udaravima/Lab_Bench/hardware/phase2-module/drc-report.txt

** Drc report for ../phase2-module.kicad_pcb **
** Created on 2026-09-27 23:24:25 **

** Found 19 DRC violations **
[silk_overlap]: Silkscreen overlap
    Rule: board setup constraints silk; Severity: warning
    @(110.5800 mm, 50.9700 mm): Reference 'R8'
    @(110.5800 mm, 50.5200 mm): Reference 'C24'
[silk_overlap]: Silkscreen overlap
    Rule: board setup constraints silk; Severity: warning
    @(92.5300 mm, 92.0300 mm): Reference 'C64'
    @(94.0000 mm, 92.1500 mm): Reference 'U10'
[silk_overlap]: Silkscreen overlap
    Rule: board setup constraints silk; Severity: warning
    @(95.1300 mm, 105.0700 mm): Reference 'R67'
    @(97.0000 mm, 105.0700 mm): Reference 'R68'
[silk_overlap]: Silkscreen overlap
    Rule: board setup constraints silk; Severity: warning
    @(102.3200 mm, 94.8200 mm): Reference 'R52'
    @(102.0700 mm, 95.3000 mm): Reference 'R16'
[silk_overlap]: Silkscreen overlap
    Rule: board setup constraints silk; Severity: warning
    @(113.0750 mm, 105.1000 mm): Reference 'J2'
    @(113.0000 mm, 105.0300 mm): Reference 'R35'
[silk_overlap]: Silkscreen overlap
    Rule: board setup constraints silk; Severity: warning
    @(103.9700 mm, 100.9000 mm): Reference 'C43'
    @(103.3700 mm, 100.7300 mm): Reference 'R64'
[silk_overlap]: Silkscreen overlap
    Rule: board setup constraints silk; Severity: warning
    @(131.1500 mm, 83.5400 mm): Line on F.Silkscreen
    @(131.0600 mm, 74.6044 mm): Line on F.Silkscreen
[silk_overlap]: Silkscreen overlap
    Rule: board setup constraints silk; Severity: warning
    @(60.2200 mm, 46.4000 mm): Reference 'R73'
    @(60.5000 mm, 47.2700 mm): Reference 'R75'
[silk_over_copper]: Silkscreen clipped by solder mask
    Local override; Severity: warning
    @(114.0200 mm, 93.3000 mm): Reference 'Q5'
[silk_over_copper]: Silkscreen clipped by solder mask
    Local override; Severity: warning
    @(110.0000 mm, 102.9500 mm): Reference 'U7'
[silk_over_copper]: Silkscreen clipped by solder mask
    Local override; Severity: warning
    @(107.8500 mm, 92.8500 mm): Reference 'D4'
[silk_over_copper]: Silkscreen clipped by solder mask
    Local override; Severity: warning
    @(105.9300 mm, 53.1200 mm): Reference 'R5'
[silk_over_copper]: Silkscreen clipped by solder mask
    Local override; Severity: warning
    @(109.9300 mm, 93.3000 mm): Reference 'Q6'
[silk_edge_clearance]: Silkscreen clipped by board edge
    Rule: board setup constraints silk; Severity: warning
    @(150.0000 mm, 110.0000 mm): Line on Edge.Cuts
    @(93.7800 mm, 110.0800 mm): Reference 'R65'
[via_dangling]: Via is not connected or connected on only one layer
    Local override; Severity: warning
    @(98.9500 mm, 108.7500 mm): Via [5V0] on F.Cu - B.Cu
[track_dangling]: Track has unconnected end
    Local override; Severity: warning
    @(106.1750 mm, 55.3500 mm): Track [PS_DITH] on In2.Cu, length 8.9095 mm
[via_dangling]: Via is not connected or connected on only one layer
    Local override; Severity: warning
    @(97.2500 mm, 49.3000 mm): Via [PS_FPWM] on F.Cu - B.Cu
[via_dangling]: Via is not connected or connected on only one layer
    Local override; Severity: warning
    @(97.9000 mm, 50.6000 mm): Via [PS_RES] on F.Cu - B.Cu
[via_dangling]: Via is not connected or connected on only one layer
    Local override; Severity: warning
    @(95.2500 mm, 50.1000 mm): Via [PS_RT] on F.Cu - B.Cu

** Found 0 unconnected pads **

** Found 0 Footprint errors **

** End of Report **
