udaravima/Lab_Bench/hardware/phase3-backplane/drc-report.txt

** Drc report for /home/fire310w/Documents/Hobbies/Lab_Bench/hardware/phase3-backplane/tools/../phase3-backplane.kicad_pcb **
** Created on 2026-07-26 07:59:22 **

** Found 0 DRC violations **

** Found 0 unconnected pads **

** Found 0 Footprint errors **

** End of Report **
