udaravima/Lab_Bench/docs/10-manager-firmware.md

# 10 — Manager Firmware (ESP32-S3, Phase 3)

Firmware in `firmware/manager/` for the rack controller. Same split as the
module firmware (docs/07): a **hardware-independent core**
(`firmware/manager/core/manager_core.{h,c}`, host-tested in
`firmware/tests`) implements every protocol/policy decision; a thin
ESP-IDF shell binds it to TWAI, I²C, USB and the UI. The core reuses
`firmware/common/labbench_can.h` verbatim.

## Design rule

**The manager is never safety-critical.** Modules self-regulate and
self-protect (docs/01); a manager crash mid-charge leaves the module's
analog CV/CC + local watchdogs in charge (comms-loss policy, docs/03 §6).
The manager's own hard action — E-stop — is a GPIO pulling the hardware
/HW_ENABLE line that works with the core hung.

## Core responsibilities (all in manager_core, host-tested)

| Function | Spec | Mechanism |
|---|---|---|
| Discovery | docs/03 §6 | HELLO ⇒ channel known; PRESENT mask (TCA9535) shows seated-but-silent slots |
| Supervision | matrix #15 | STATUS is the module heartbeat: >1 s silent ⇒ lost, alarmed, dropped from the budget |
| Heartbeat | docs/03 §6 | GLOBAL_STATE at 1 Hz (budget, flags, rolling seq) |
| Setpoint ack/retry | docs/03 §3 | SET_VI pending until a STATUS echoes the new setpoints; retry at 50 ms, 3 attempts, then `unresponsive` |
| Budget arbiter | docs/01 §2, matrix #17 | committed = Σ active channels max(measured, vset×iset) + request; refuse enables/raises that exceed it |
| Charge sequencer | docs/03 §7 | per-channel CC→CV→cutoff profile; only *schedules setpoints* — module analog loops regulate |
| Global off / E-stop | matrix #16 | GLOBAL_OFF broadcast (core) + /HW_ENABLE GPIO (shell, works even if core wedges) |

Charge sequencer states:
`IDLE → RAMP (LIMITS hold + SET_VI + OUTPUT on+DEM) → CC (STATUS.CC-active)
→ CV (CC-active clears near V_float) → TERM_WAIT (I < I_cutoff, hold
timer) → DONE (OUTPUT off)`; any module fault, channel loss, or the t_max
guard ⇒ `ABORT` (OUTPUT off, latched reason). Termination uses TELEM_VI
current, cutoff hold defaults 30 s.

Core I/O contract (no HAL, no floats, no allocation): frames in via
`lb_mgr_rx()`, time via `lb_mgr_tick(dt_ms)`, requests via `lb_mgr_*()`
calls; outgoing frames accumulate in a fixed ring drained by
`lb_mgr_tx_pop()`. Same host-test harness as module_core
(`cd firmware/tests && make test`).

## UI and SCPI cores (v0.2 — host-tested like manager_core)

Two more hardware-independent cores sit beside manager_core, same rules
(C99, no floats, no allocation), so **every** UI/SCPI decision is
host-verified before silicon:

- **`ui_core.{h,c}`** (tests/test_ui.c): front-panel state machine +
  renderer. Consumes encoder/key events, renders a 40×15 **text model**
  (`text[][]` + per-row attribute NORM/SEL/ALERT/EDIT + `beep` flag);
  the shell only paints glyphs. Screens: channel LIST (8 rows + budget
  header), channel DETAIL (setpoints/telemetry/output/fault-clear/charge
  abort), digit-wise EDIT (rotate = ±digit, push = next digit, hold =
  commit through the budget arbiter), SYSTEM (budget edit, global
  off/resume, all-off, backplane INA228 bus meter). Front-panel keys
  toggle their channel's output from any screen; refusals and new fault
  bits raise a message line + beep (edge-triggered, once per fault bit).
- **`scpi_core.{h,c}`** (tests/test_scpi.c): line-in/reply-out SCPI
  (docs/01 §6): `*IDN?`, `*RST`, `SOURn:VOLT|CURR` (set/query, decimal
  parsed to µV/µA integer), `MEASn:VOLT?|CURR?|POW?`, `OUTPn
  ON|OFF|DEM|DROOP|DEMDROOP` + live `OUTPn?`, `SYST:BUDG`,
  `SYST:SLOTn?` status CSV, `SYST:ERR?` FIFO (depth 4 + overflow mark).
  Set commands the core refuses (budget #17, lost channel) queue
  `-221,"Settings conflict"` — remote scripts see exactly the arbiter
  the UI sees.

## ESP-IDF shell (firmware/manager/idf/ — requires ESP-IDF ≥5.1 to build)

Managed components (main/idf_component.yml, fetched on first `idf.py
build`): `espressif/esp_lcd_ili9341`, `espressif/esp_tinyusb`.

**First compile (2026-09-27): builds clean, zero warnings in `main`,**
IDF v5.3.2, 355 KB app image (IRAM full at 16383/16384 B, from IDF +
TinyUSB, not our code). Built with esp_lcd_ili9341 1.2.0, esp_tinyusb
1.7.6~1, tinyusb 0.18.0~6. Two fixes were needed: `CONFIG_TINYUSB_CDC_ENABLED=y`
in sdkconfig.defaults (esp_tinyusb ships CDC off, so `tusb_cdc_acm.h`
hard-errors), and `esp_lcd_ili9341`/`esp_tinyusb` named in main's
`REQUIRES` so the includes resolve whether components come from the
registry or from local copies (`IDF_COMPONENT_MANAGER=0` +
`EXTRA_COMPONENT_DIRS`). Still untested on silicon.

| Piece | Binding |
|---|---|
| TWAI @ 500 k | IO4 TX / IO5 RX (docs/09 §3), rx task → `lb_mgr_rx`, 10 ms tick drains the ring |
| Tick | 10 ms esp_timer → `lb_mgr_tick` |
| I²C | IO8/IO9: TCA9535 (0x20, PRESENT+keys polled at 60 ms; INT on IO7 is a bring-up TODO) + backplane INA228 (0x40: 250 µΩ, ADCRANGE=0, CURRENT_LSB 400 µA, SHUNT_CAL 1311, 1 Hz poll → bus meter row) |
| E-stop | IO21 kill FET (assert), IO38 line sense (UI alert = bring-up TODO) |
| Display | `display.c`: esp_lcd + ILI9341 @20 MHz SPI2, paints the ui_core text model with the 8×16 VGA font (`font8x16.h`, machine-extracted from the system PSF font by `tools/gen_font.py` — never hand-typed). Rotation + RGB565 byte order are THE two bring-up knobs. Backlight = LEDC on IO16. Touch parked (T_CS held high) |
| Encoder | `encoder.c`: PCNT ×4 quadrature + glitch filter, 4 counts/detent; SW: <700 ms = push, 700 ms = hold |
| SCPI | `scpi_usb.c`: TinyUSB CDC-ACM on the native USB PHY, line buffer → `lb_scpi_line` under the manager mutex |
| Buzzer | IO41, 60 ms one-shot pulse on ui_core's `beep` |
| Wi-Fi | later phase; nothing in the cores depends on it |

Locking: one mutex guards the three cores; takers are the CAN rx task,
the 10 ms tick, the 20 ms UI task and the TinyUSB rx callback. The shell
compiles-by-inspection only — it is **not** built in CI here (no ESP-IDF
on this machine) — the core logic is what's verified, by the host suite,
exactly like the module firmware before its silicon.

## Bring-up checklist

1. Host: `cd firmware/tests && make test` — manager suite green.
2. Bench: manager + USB-CAN dongle sniffing: GLOBAL_STATE at 1 Hz, seq
   increments; E-stop key drops /HW_ENABLE (scope, <1 ms — exit criterion).
3. With one module on the bench harness: HELLO seen, channel appears,
   SET_VI/OUTPUT round-trip, STATUS ack clears the retry state.
4. Pull the module's CAN mid-run: lost alarm at 1 s, budget shrinks,
   module's own comms-loss policy fires at 3 s (its exit criterion).
5. Charge-sequence a bench battery through CC→CV→cutoff; reboot the
   manager mid-charge: module holds (policy=hold), sequencer resumes
   supervision from telemetry (docs/05 Phase-3 exit criterion).
6. Display: expect rotation/byte-order wrong on first light-up — flip
   `swap_xy`/`mirror` and the palette byteswap in display.c, nothing
   else. Then encoder direction (swap the two PCNT channels if CW/CCW
   are reversed).
7. SCPI: `*IDN?` over /dev/ttyACM*, then script a SOUR/OUTP/MEAS
   round-trip against a live module; verify a budget-refused `SOURn`
   answers `SYST:ERR?` with -221.
