udaravima/Lab_Bench/hardware/phase1-module/bom/phase1-module-bom.csv

Item | Qty | References | Value | Footprint | LCSC | MPN | Manufacturer | Unit USD | Ext USD | Note
1 | 1 | C1 | 10n | Capacitor_SMD:C_0603_1608Metric | C57112 | 0603B103K500NT | FH | 0.0108 | 0.011
2 | 1 | C2 | 22n | Capacitor_SMD:C_0603_1608Metric | C21122 | CL10B223KB8NNNC | Samsung Electro-Mechanics | 0.0083 | 0.008
3 | 17 | C3 C5 C27 C28 C33 C34 C41 C43 C52 C62 C68 C69 C70 C71 C72 C73 C74 | 100n | Capacitor_SMD:C_0603_1608Metric | C14663 | CC0603KRX7R9BB104 | YAGEO | 0.0122 | 0.207
4 | 1 | C4 | 150n | Capacitor_SMD:C_0603_1608Metric | C513735 | CC0603KRX7R9BB154 | YAGEO | 0.013 | 0.013 | 50 V part (no Basic 150 nF)
5 | 1 | C17 | DNP | Capacitor_SMD:C_0603_1608Metric |  |  |  |  |  | do not populate (value says DNP)
6 | 1 | C18 | 47n | Capacitor_SMD:C_0603_1608Metric | C1622 | CL10B473KB8NNNC | Samsung Electro-Mechanics | 0.0073 | 0.007
7 | 1 | C19 | 15p | Capacitor_SMD:C_0603_1608Metric | C1644 | CL10C150JB8NNNC | Samsung Electro-Mechanics | 0.0113 | 0.011 | C0G
8 | 4 | C20 C75 C76 C77 | 10u/50V X7R | Capacitor_SMD:C_1210_3225Metric | C77102 | GRM32ER71H106KA12L | Murata Electronics | 0.3274 | 1.31 | 10 uF 50 V X7R: no 22 uF 50 V 1210 is stocked, so the design value is now 10u (phase-2 uses 10 uF too). 4 x ~4.5 uF at 30 V bias gives about 0.3 Vpp input ripple at 8 A, D = 0.5, 350 kHz; ~1 A RMS each; C21 is the bulk
9 | 1 | C21 | 220u/50V | Capacitor_SMD:CP_Elec_10x10.5 | C2887271 | RVT220UF50V67RV0021 | KNSCHA | 0.1412 | 0.141 | SMD D10x10.2 aluminium, fits CP_Elec_10x10.5
10 | 2 | C22 C78 | 220u/25V poly | Capacitor_SMD:CP_Elec_8x11.9 | C46550471 | MA35V220M8X12 | jieerrui | 0.2872 | 0.574 | 35 V polymer SMD D8x11.5, 16 mOhm; fits CP_Elec_8x11.9
11 | 4 | C23 C79 C80 C81 | 22u/25V X7R | Capacitor_SMD:C_1210_3225Metric | C5341638 | CC1210KKX7R8BB226 | YAGEO | 0.596 | 2.384 | 22 uF 25 V X7R 1210; the 5V0/3V3 positions (16 V/10 V in the value) get the same part
12 | 1 | C24 | 8.2n | Capacitor_SMD:C_0603_1608Metric | C1322360 | 0603B822K500NT | FH | 0.0053 | 0.005
13 | 1 | C25 | 120p | Capacitor_SMD:C_0603_1608Metric | C1643 | 0603CG121J500NT | FH | 0.0132 | 0.013 | C0G
14 | 1 | C26 | 3.3n | Capacitor_SMD:C_0603_1608Metric | C1613 | CL10B332KB8NNNC | Samsung Electro-Mechanics | 0.0083 | 0.008
15 | 1 | C29 | 2.2u | Capacitor_SMD:C_0603_1608Metric | C23630 | CL10A225KO8NNNC | Samsung Electro-Mechanics | 0.0181 | 0.018 | 16 V X5R on the 7.5 V VCC rail
16 | 3 | C31 C32 C44 | 1n | Capacitor_SMD:C_0603_1608Metric | C1588 | CL10B102KB8NNNC | Samsung Electro-Mechanics | 0.0089 | 0.027
17 | 2 | C42 C53 | 1u | Capacitor_SMD:C_0603_1608Metric | C15849 | CL10A105KB8NNNC | Samsung Electro-Mechanics | 0.0752 | 0.15
18 | 2 | C50 C51 | 4.7u/50V | Capacitor_SMD:C_1210_3225Metric | C596318 | CC1210KKX7R9BB475 | YAGEO | 0.3807 | 0.761
19 | 2 | C54 C55 | 22u/16V | Capacitor_SMD:C_1210_3225Metric | C5341638 | CC1210KKX7R8BB226 | YAGEO | 0.596 | 1.192 | 22 uF 25 V X7R 1210; the 5V0/3V3 positions (16 V/10 V in the value) get the same part
20 | 1 | C56 | 10u/16V | Capacitor_SMD:C_1210_3225Metric | C77102 | GRM32ER71H106KA12L | Murata Electronics | 0.3274 | 0.327 | 10 uF 50 V X7R, same part as C20 (value says 16 V)
21 | 1 | C57 | 22u/10V | Capacitor_SMD:C_1210_3225Metric | C5341638 | CC1210KKX7R8BB226 | YAGEO | 0.596 | 0.596 | 22 uF 25 V X7R 1210; the 5V0/3V3 positions (16 V/10 V in the value) get the same part
22 | 1 | C64 | 4.7u | Capacitor_SMD:C_0603_1608Metric | C19666 | CL10A475KO8NNNC | Samsung Electro-Mechanics | 0.0294 | 0.029
23 | 1 | C65 | 1u VDDA | Capacitor_SMD:C_0603_1608Metric | C15849 | CL10A105KB8NNNC | Samsung Electro-Mechanics | 0.0752 | 0.075
24 | 2 | C66 C67 | 18p | Capacitor_SMD:C_0603_1608Metric | C1647 | CL10C180JB8NNNC | Samsung Electro-Mechanics | 0.0157 | 0.031 | C0G
25 | 4 | D1 D2 D3 D4 | BAT54W | Package_TO_SOT_SMD:SOT-323_SC-70 | C77328 | BAT54W | Jiangsu Changjing Electronics Technology Co., Ltd. | 0.0238 | 0.095 | SOT-323 single, pin 1 A / pin 3 K / pin 2 NC - check the rotation in the JLCPCB preview
26 | 1 | D5 | SMBJ33A | Diode_SMD:D_SMB | C224019 | SMBJ33A | Littelfuse | 0.122 | 0.122
27 | 1 | D6 | 1N4148W | Diode_SMD:D_SOD-323 | C2128 | 1N4148WS | Jiangsu Changjing Electronics Technology Co., Ltd. | 0.0158 | 0.016 | 1N4148WS is the SOD-323 version (1N4148W is SOD-123)
28 | 1 | D7 | STATUS | LED_SMD:LED_0603_1608Metric | C2286 | KT-0603R | Hubei KENTO Elec | 0.0075 | 0.007 | red 0603 LED (Basic)
29 | 1 | F1 | 10A blade | Fuse:Fuse_Blade_Mini_directSolder |  |  |  |  |  | through-hole, hand-solder; the land is KiCad's direct-solder mini blade pattern, so a 10 A mini blade (ATM) fuse solders straight in with no holder (C3207114 does not fit it)
30 | 1 | J1 | VBUS IN | TerminalBlock_Phoenix:TerminalBlock_Phoenix_PT-1,5-2-5.0-H_1x02_P5.00mm_Horizontal |  |  |  |  |  | through-hole, hand-solder; SOURCING lists 2EDG 5.08 plugs C3697 for P1 bench IO, but this footprint is a 5.0 mm Phoenix PT - pick the matching header
31 | 1 | J2 | SWD | Connector_PinHeader_2.54mm:PinHeader_1x05_P2.54mm_Vertical |  |  |  |  |  | through-hole pin header: hand-solder (or pay for JLCPCB THT assembly)
32 | 1 | J3 | UART | Connector_PinHeader_2.54mm:PinHeader_1x03_P2.54mm_Vertical |  |  |  |  |  | through-hole pin header: hand-solder (or pay for JLCPCB THT assembly)
33 | 1 | J4 | OUTPUT | TerminalBlock_Phoenix:TerminalBlock_Phoenix_PT-1,5-2-5.0-H_1x02_P5.00mm_Horizontal |  |  |  |  |  | through-hole, hand-solder; SOURCING lists 2EDG 5.08 plugs C3697 for P1 bench IO, but this footprint is a 5.0 mm Phoenix PT - pick the matching header
34 | 1 | J5 | BACKPLANE | Connector_PinHeader_2.54mm:PinHeader_1x08_P2.54mm_Vertical |  |  |  |  |  | through-hole pin header: hand-solder (or pay for JLCPCB THT assembly)
35 | 1 | J6 | FAN | Connector_PinHeader_2.54mm:PinHeader_1x02_P2.54mm_Vertical |  |  |  |  |  | through-hole pin header: hand-solder (or pay for JLCPCB THT assembly)
36 | 1 | L1 | 10u MWSA1707S-100/XAL1350 | labbench:L_1707_XAL1510 | C5240401 | MWSA1707S-100MT | Sunlord | 1.68 | 1.68 | 16.5 A Isat / 10.5 A Irms; L_1707_XAL1510 superset land
37 | 1 | L2 | 33u/1.2A | Inductor_SMD:L_Changjiang_FNR5040S | C167973 | FNR5040S330MT | cjiang (Changjiang Microelectronics) | 0.06 | 0.06 | 5x5x4 mm shielded, KiCad L_Changjiang_FNR5040S land; Isat 1.30 A min covers the 33u/1.2A value. Any 5040-size 33 uH >=1.2 A part with the same 2.3 mm pad gap fits
38 | 2 | Q1 Q2 | CSD18563Q5A | labbench:PowerFET_SON5x6_GDS | C179626 | NTMFS5C670NLT1G | onsemi | 0.49 | 0.98 | stands in for CSD18563Q5A (C77239, still out of stock 2026-10-06). 60 V, 6.1 mOhm, Qg 20 nC vs 5.7 mOhm / 15 nC; same S-S-S-G / drain-tab pinout. Overlay on the TI Q5A land checked against case 488AA: terminals within 0.14 mm of the TI part's (E 6.15 vs 6.00, L 0.575 vs 0.61, K 1.35 vs 1.10), 0.35 mm from the drain land edge vs 0.24 for the TI part. Q3/Q4 dissipate about 0.6 W each at 10 A
39 | 2 | Q3 Q4 | 60V NFET | labbench:PowerFET_SON5x6_GDS | C179626 | NTMFS5C670NLT1G | onsemi | 0.49 | 0.98 | stands in for CSD18563Q5A (C77239, still out of stock 2026-10-06). 60 V, 6.1 mOhm, Qg 20 nC vs 5.7 mOhm / 15 nC; same S-S-S-G / drain-tab pinout. Overlay on the TI Q5A land checked against case 488AA: terminals within 0.14 mm of the TI part's (E 6.15 vs 6.00, L 0.575 vs 0.61, K 1.35 vs 1.10), 0.35 mm from the drain land edge vs 0.24 for the TI part. Q3/Q4 dissipate about 0.6 W each at 10 A
40 | 5 | Q5 Q6 Q7 Q8 Q9 | 2N7002 | Package_TO_SOT_SMD:SOT-23 | C8545 | 2N7002 | Jiangsu Changjing Electronics Technology Co., Ltd. | 0.0178 | 0.089
41 | 1 | R1 | 25.5K 0.1% | Resistor_SMD:R_0603_1608Metric | C861257 | RT0603BRD0725K5L | YAGEO | 0.0353 | 0.035 | 0.1 % 25 ppm thin film
42 | 1 | R2 | 1.0K 0.1% | Resistor_SMD:R_0603_1608Metric | C110776 | RT0603BRD071KL | YAGEO | 0.0327 | 0.033 | 0.1 % 25 ppm thin film
43 | 2 | R3 R6 | 10K 0.1% | Resistor_SMD:R_0603_1608Metric | C95204 | RT0603BRD0710KL | YAGEO | 0.0327 | 0.065 | 0.1 % 25 ppm thin film
44 | 1 | R4 | 33K | Resistor_SMD:R_0603_1608Metric | C4216 | 0603WAF3302T5E | UNI-ROYAL | 0.0022 | 0.002
45 | 2 | R5 R8 | 3.9K | Resistor_SMD:R_0603_1608Metric | C23018 | 0603WAF3901T5E | UNI-ROYAL | 0.0027 | 0.005
46 | 1 | R7 | 15K | Resistor_SMD:R_0603_1608Metric | C22809 | 0603WAF1502T5E | UNI-ROYAL | 0.0029 | 0.003
47 | 6 | R16 R18 R19 R22 R23 R52 | 100K | Resistor_SMD:R_0603_1608Metric | C25803 | 0603WAF1003T5E | UNI-ROYAL | 0.0031 | 0.019
48 | 1 | R17 | DNP snub | Resistor_SMD:R_0603_1608Metric |  |  |  |  |  | do not populate (value says DNP)
49 | 2 | R20 R50 | 100K 1% | Resistor_SMD:R_0603_1608Metric | C25803 | 0603WAF1003T5E | UNI-ROYAL | 0.0031 | 0.006
50 | 1 | R21 | 13K 1% | Resistor_SMD:R_0603_1608Metric | C22797 | 0603WAF1302T5E | UNI-ROYAL | 0.0029 | 0.003
51 | 1 | R24 | 8.2K | Resistor_SMD:R_0603_1608Metric | C25981 | 0603WAF8201T5E | UNI-ROYAL | 0.0035 | 0.004
52 | 1 | R25 | 1.0K | Resistor_SMD:R_0603_1608Metric | C21190 | 0603WAF1001T5E | UNI-ROYAL | 0.0026 | 0.003
53 | 1 | R26 | 28.7K 1% | Resistor_SMD:R_0603_1608Metric | C22928 | 0603WAF2872T5E | UNI-ROYAL | 0.0016 | 0.002
54 | 1 | R27 | 2.2K 1W preload | Resistor_SMD:R_2512_6332Metric | C421608 | 25121WF2201T4E | UNI-ROYAL | 0.0541 | 0.054 | 1 W 2512
55 | 1 | R28 | 365 1% | Resistor_SMD:R_0603_1608Metric | C227839 | AC0603FR-07365RL | YAGEO | 0.005 | 0.005
56 | 1 | R29 | 4.7 | Resistor_SMD:R_0603_1608Metric | C23164 | 0603WAF470KT5E | UNI-ROYAL | 0.0026 | 0.003
57 | 1 | R30 | 2m/1W Kelvin | Resistor_SMD:R_2512_6332Metric | C2994640 |  |  | 0.06 | 0.06 | 2 mOhm 2512 3 W 1 %; check TCR on datasheet
58 | 2 | R31 R66 | 1K | Resistor_SMD:R_0603_1608Metric | C21190 | 0603WAF1001T5E | UNI-ROYAL | 0.0026 | 0.005
59 | 1 | R32 | 69.8K 0.1% | Resistor_SMD:R_0603_1608Metric | C861526 | RT0603BRD0769K8L | YAGEO | 0.0575 | 0.058 | 0.1 % 25 ppm thin film
60 | 1 | R33 | 10.0K 0.1% | Resistor_SMD:R_0603_1608Metric | C95204 | RT0603BRD0710KL | YAGEO | 0.0327 | 0.033 | 0.1 % 25 ppm thin film
61 | 3 | R43 R64 R65 | 10K | Resistor_SMD:R_0603_1608Metric | C25804 | 0603WAF1002T5E | UNI-ROYAL | 0.0018 | 0.005
62 | 1 | R44 | 47K | Resistor_SMD:R_0603_1608Metric | C25819 | 0603WAF4702T5E | UNI-ROYAL | 0.0037 | 0.004
63 | 1 | R45 | 158K 1% | Resistor_SMD:R_0603_1608Metric | C22883 | 0603WAF1583T5E | UNI-ROYAL | 0.0013 | 0.001
64 | 1 | R46 | 20K 1% | Resistor_SMD:R_0603_1608Metric | C4184 | 0603WAF2002T5E | UNI-ROYAL | 0.0023 | 0.002
65 | 4 | R47 R61 R67 R68 | 10K 1% | Resistor_SMD:R_0603_1608Metric | C25804 | 0603WAF1002T5E | UNI-ROYAL | 0.0018 | 0.007
66 | 1 | R48 | 31.6K 1% | Resistor_SMD:R_0603_1608Metric | C25967 | 0603WAF3162T5E | UNI-ROYAL | 0.0022 | 0.002
67 | 1 | R51 | 24.9K 1% | Resistor_SMD:R_0603_1608Metric | C25962 | 0603WAF2492T5E | UNI-ROYAL | 0.0016 | 0.002
68 | 1 | R60 | 200K 1% | Resistor_SMD:R_0603_1608Metric | C25811 | 0603WAF2003T5E | UNI-ROYAL | 0.0023 | 0.002
69 | 2 | R62 R63 | 4.7K | Resistor_SMD:R_0603_1608Metric | C23162 | 0603WAF4701T5E | UNI-ROYAL | 0.0028 | 0.006
70 | 2 | RT1 RT2 | 10K B3950 | Resistor_SMD:R_0603_1608Metric | C2892547 | KNTC0603/10KF3950 | KUU | 0.0298 | 0.06 | 10k 1 % NTC sold as 3950; the catalogue also lists 3987 K (likely B25/85) - match the firmware B constant
71 | 1 | U1 | DAC80502DRXT | labbench:DAC80502_DRX_WSON-10 | C1880990 | DAC80502DRXR | TI | 4.19 | 4.19 | value says DRXT; R/T differ only in reel size
72 | 1 | U2 | OPA2333 | Package_SO:VSSOP-8_3.0x3.0mm_P0.65mm | C19608 | OPA2333AIDGKR | TI | 1.14 | 1.14
73 | 1 | U3 | LM5145RGYR | labbench:LM5145_RGY0020B | C485912 | LM5145RGYR | TI | 1.55 | 1.55
74 | 1 | U4 | INA240A3 | Package_SO:SOIC-8_3.9x4.9mm_P1.27mm | C2060584 | INA240A3DR | TI | 1.87 | 1.87
75 | 1 | U5 | INA228 | Package_SO:VSSOP-10_3x3mm_P0.5mm | C5214669 | INA228AQDGSRQ1 | TI | 17.16 | 17.16 | automotive grade of INA228AIDGSR, same VSSOP-10 pinout and register map (no firmware change); the AIDGSR (C2887910) was still out of stock on 2026-09-28 - swap back if it returns, it is about a quarter of the price. Only 5 in stock on 2026-10-06: order early
76 | 1 | U6 | LTC7004 | Package_SO:MSOP-10-1EP_3x3mm_P0.5mm_EP1.68x1.88mm | C690105 | LTC7004EMSE#PBF | ADI | 11.62 | 11.62 | thin stock (25 on 2026-10-06) - order early (IMSE fallback)
77 | 1 | U7 | TLV7011DCK | Package_TO_SOT_SMD:SOT-353_SC-70-5 | C193688 | TLV7011DCKR | TI | 0.27 | 0.27 | SC-70-5 (DCK)
78 | 1 | U8 | LMR36015AQRNXRQ1 | labbench:LMR36015_RNX_VQFN-HR-12 | C1850345 | LMR36015ARNXR | TI | 1.91 | 1.91 | symbol value says LMR36015AQRNXRQ1 (automotive); SOURCING picked the commercial ARNXR, same RNX package
79 | 1 | U9 | NCP1117-3.3 | Package_TO_SOT_SMD:SOT-223-3_TabPin2 | C26537 | NCP1117ST33T3G | onsemi | 0.21 | 0.21
80 | 1 | U10 | STM32G431CBT6 | Package_QFP:LQFP-48_7x7mm_P0.5mm | C529355 | STM32G431CBT6 | ST | 2.85 | 2.85
81 | 1 | U11 | TCAN1042HGV | Package_SO:SOIC-8_3.9x4.9mm_P1.27mm | C485806 | TCAN1042VDRQ1 | TI | 0.57 | 0.57 | symbol value says TCAN1042HGV; SOURCING picked the V (VIO) variant, same SOIC-8 pinout
82 | 1 | Y1 | 8MHz | Crystal:Crystal_SMD_3225-4Pin_3.2x2.5mm | C403948 | TAXM8M4RFDCET2T | Yajingxin | 0.147 | 0.147 | 8 MHz 3225, CL = 12 pF (load caps 18 p); replaces C400090, which is the CL = 10 pF version
 | 136 |  |  |  |  |  |  |  | 55.9 | 127/136 placements have an LCSC number; total covers those only (qty-1, SOURCING.md 2026-07-18)
