udaravima/Lab_Bench/hardware/phase2-module/bom/phase2-module-jlcpcb.csv

Comment | Designator | Footprint | LCSC Part #
10n | C1 | C_0603_1608Metric
22n | C2 | C_0603_1608Metric
100n | C3,C5,C27,C28,C33,C34,C35,C39,C41,C43,C52,C62,C68,C69,C70,C71,C72,C73,C74,C90,C91 | C_0603_1608Metric
150n | C4 | C_0603_1608Metric
10u/50V X7S | C6,C7,C8,C9,C10,C11,C12,C13,C38,C40,C45,C46,C47,C48 | C_1210_3225Metric | C126612
470u/50V | C14 | CP_Radial_D10.0mm_P5.00mm | C106666
220u/35V hybrid | C15,C16,C36,C37 | CP_Elec_10x10.5 | C454349
47n | C18,C20 | C_0603_1608Metric
470n | C19 | C_0603_1608Metric
1u | C21,C30,C42,C53 | C_0603_1608Metric
2.2u | C22,C23 | C_0603_1608Metric
27n | C24 | C_0603_1608Metric
2.2n | C25 | C_0603_1608Metric
1n | C31,C32,C44 | C_0603_1608Metric
4.7u/50V | C50,C51 | C_1210_3225Metric
22u/16V | C54,C55 | C_1210_3225Metric
10u/16V | C56 | C_1210_3225Metric
22u/10V | C57 | C_1210_3225Metric
4.7u | C64 | C_0603_1608Metric
1u VDDA | C65 | C_0603_1608Metric
18p | C66,C67 | C_0603_1608Metric
BAT54W | D1,D2,D3,D4 | SOT-323_SC-70
SMBJ33A | D5 | D_SMB
1N4148W | D6 | D_SOD-323
STATUS | D7 | LED_0603_1608Metric
TL431B 2.495V | D8 | SOT-23 | C41283
35A blade | F1 | Fuse_Blade_ATO_directSolder | C3207132
XT60PW-M SLOT PWR | J1 | XT60PW-M | C98732
SWD | J2 | PinHeader_1x05_P2.54mm_Vertical
UART | J3 | PinHeader_1x03_P2.54mm_Vertical
XT60PW-M OUTPUT | J4 | XT60PW-M | C98732
SLOT SIGNALS | J5 | PinHeader_1x08_P2.54mm_Vertical
FAN | J6 | PinHeader_1x02_P2.54mm_Vertical
6.8u MWSA1707S/XAL1510 | L1,L3 | L_1707_XAL1510 | C6238332
33u/1.2A | L2 | L_Changjiang_FNR5040S | C167973
CSD18540Q5B | Q1,Q2,Q3,Q4,Q10,Q11,Q12,Q13 | PowerFET_SON5x6_GDS | C86513
2N7002 | Q5,Q6,Q7,Q8,Q9 | SOT-23
CSD19536KTT | Q14 | TO-263-2 | C2687963
46.4K 0.1% | R1 | R_0603_1608Metric
1.0K 0.1% | R2 | R_0603_1608Metric
10K 0.1% | R3,R6 | R_0603_1608Metric
33K | R4 | R_0603_1608Metric
5.6K | R5,R8 | R_0603_1608Metric
15K | R7 | R_0603_1608Metric
100K | R16,R18,R19,R20,R22,R23,R38,R52,R75 | R_0603_1608Metric
2.2K | R24 | R_0603_1608Metric
63.4K 1% | R26 | R_0603_1608Metric
4.7K 0.5W preload | R27 | R_2512_6332Metric
4.7 | R29 | R_0603_1608Metric
1m0 3W Kelvin | R30,R34 | R_2512_6332Metric | C46634444
1K | R31,R66 | R_0603_1608Metric
110K 0.1% | R32 | R_0603_1608Metric
10.0K 0.1% | R33 | R_0603_1608Metric
267K 1% | R35 | R_0603_1608Metric
7m5 1W | R36,R37,R42,R57 | R_1206_3216Metric | C49837985
10K | R43,R64,R65 | R_0603_1608Metric
47K | R44 | R_0603_1608Metric
215K 0.1% | R45 | R_0603_1608Metric
20.0K 0.1% | R46 | R_0603_1608Metric
10K 1% | R47,R61,R67,R68 | R_0603_1608Metric
100K 1% | R50 | R_0603_1608Metric
24.9K 1% | R51 | R_0603_1608Metric
200K 1% | R60 | R_0603_1608Metric
4.7K | R62,R63 | R_0603_1608Metric
1m5 3W Kelvin | R70 | R_2512_6332Metric | C49837991
47.5K 1% | R71 | R_0603_1608Metric
12.1K 1% | R72 | R_0603_1608Metric
4.87K 1% | R73 | R_0603_1608Metric
15.0K 1% | R74 | R_0603_1608Metric
10K B3950 | RT1,RT2 | R_0603_1608Metric
DAC80502DRXT | U1 | DAC80502_DRX_WSON-10 | C1880990
OPA2333 | U2 | VSSOP-8_3.0x3.0mm_P0.65mm | C19608
LM5143RHAR | U3 | LM5143_RHA0040P | C5219258
INA240A3 | U4 | SOIC-8_3.9x4.9mm_P1.27mm | C2060584
INA228 | U5 | VSSOP-10_3x3mm_P0.5mm | C5214669
LTC7004 | U6 | MSOP-10-1EP_3x3mm_P0.5mm_EP1.68x1.88mm | C690105
TLV7011DCK | U7 | SOT-353_SC-70-5 | C193688
LMR36015AQRNXRQ1 | U8 | LMR36015_RNX_VQFN-HR-12 | C1850345
NCP1117-3.3 | U9 | SOT-223-3_TabPin2 | C26537
STM32G431CBT6 | U10 | LQFP-48_7x7mm_P0.5mm | C529355
TCAN1042HGV | U11 | SOIC-8_3.9x4.9mm_P1.27mm | C485806
LM5069MM-2 | U12 | VSSOP-10_3x3mm_P0.5mm | C111822
TS5A3166 | U13 | SOT-23-5 | C353035
8MHz | Y1 | Crystal_SMD_3225-4Pin_3.2x2.5mm | C403948
