udaravima/Lab_Bench/hardware/phase3-backplane/bom/phase3-backplane-bom.csv

Item | Qty | References | Value | Footprint | LCSC | MPN | Manufacturer | Unit USD | Ext USD | Note
1 | 2 | C1 C3 | 100n | Capacitor_SMD:C_0603_1608Metric
2 | 1 | C2 | 470u/50V | Capacitor_SMD:CP_Elec_16x17.5 |  |  |  |  |  | SOURCING's 470 uF part C106666 is THT D10; this board uses a 16x17.5 SMD footprint - choose an SMD part
3 | 1 | D5 | SMBJ33A | Diode_SMD:D_SMB
4 | 1 | J1 | MANAGER | Connector_PinHeader_2.54mm:PinHeader_1x20_P2.54mm_Vertical
5 | 1 | J2 | E-STOP NC (jumper if absent) | Connector_PinHeader_2.54mm:PinHeader_1x02_P2.54mm_Vertical
6 | 1 | J10 | SLOT0 XT60PW-F | labbench:XT60PW-F | C428722 | XT60PW-F | Amass | 0.56 | 0.56
7 | 1 | J11 | SLOT1 XT60PW-F | labbench:XT60PW-F | C428722 | XT60PW-F | Amass | 0.56 | 0.56
8 | 1 | J12 | SLOT2 XT60PW-F | labbench:XT60PW-F | C428722 | XT60PW-F | Amass | 0.56 | 0.56
9 | 1 | J13 | SLOT3 XT60PW-F | labbench:XT60PW-F | C428722 | XT60PW-F | Amass | 0.56 | 0.56
10 | 1 | J14 | SLOT4 XT60PW-F | labbench:XT60PW-F | C428722 | XT60PW-F | Amass | 0.56 | 0.56
11 | 1 | J15 | SLOT5 XT60PW-F | labbench:XT60PW-F | C428722 | XT60PW-F | Amass | 0.56 | 0.56
12 | 1 | J16 | SLOT6 XT60PW-F | labbench:XT60PW-F | C428722 | XT60PW-F | Amass | 0.56 | 0.56
13 | 1 | J17 | SLOT7 XT60PW-F | labbench:XT60PW-F | C428722 | XT60PW-F | Amass | 0.56 | 0.56
14 | 1 | J20 | SLOT0 SIG | Connector_PinHeader_2.54mm:PinHeader_1x08_P2.54mm_Vertical
15 | 1 | J21 | SLOT1 SIG | Connector_PinHeader_2.54mm:PinHeader_1x08_P2.54mm_Vertical
16 | 1 | J22 | SLOT2 SIG | Connector_PinHeader_2.54mm:PinHeader_1x08_P2.54mm_Vertical
17 | 1 | J23 | SLOT3 SIG | Connector_PinHeader_2.54mm:PinHeader_1x08_P2.54mm_Vertical
18 | 1 | J24 | SLOT4 SIG | Connector_PinHeader_2.54mm:PinHeader_1x08_P2.54mm_Vertical
19 | 1 | J25 | SLOT5 SIG | Connector_PinHeader_2.54mm:PinHeader_1x08_P2.54mm_Vertical
20 | 1 | J26 | SLOT6 SIG | Connector_PinHeader_2.54mm:PinHeader_1x08_P2.54mm_Vertical
21 | 1 | J27 | SLOT7 SIG | Connector_PinHeader_2.54mm:PinHeader_1x08_P2.54mm_Vertical
22 | 1 | J30 | VBUS+ LUG M6 | MountingHole:MountingHole_6.4mm_M6_Pad_TopBottom
23 | 1 | J31 | RETURN LUG M6 | MountingHole:MountingHole_6.4mm_M6_Pad_TopBottom
24 | 1 | R1 | 1K | Resistor_SMD:R_0603_1608Metric
25 | 1 | R2 | 120R slot0-end | Resistor_SMD:R_0603_1608Metric
26 | 1 | R3 | 120R slot7-end | Resistor_SMD:R_0603_1608Metric
27 | 2 | RS1 RS2 | 0m5 3920 | labbench:R3920_BVS | C466580 | BVS-M-R0005 | Isabellenhuette | 0.6 | 1.2 | 2 in parallel = 0.25 mOhm; verify power rating on datasheet
28 | 1 | U1 | INA228 | Package_SO:VSSOP-10_3x3mm_P0.5mm | C5214669 | INA228AQDGSRQ1 | TI | 17.16 | 17.16 | automotive grade of INA228AIDGSR, same VSSOP-10 pinout and register map (no firmware change); the AIDGSR (C2887910) was still out of stock on 2026-09-28 - swap back if it returns, it is about a quarter of the price
 | 30 |  |  |  |  |  |  |  | 22.84 | 11/30 placements have an LCSC number; total covers those only (qty-1, SOURCING.md 2026-07-18)
