udaravima/Lab_Bench/hardware/phase3-backplane/bom/phase3-backplane-jlcpcb.csv

Comment | Designator | Footprint | LCSC Part #
100n | C1,C3 | C_0603_1608Metric
470u/50V | C2 | CP_Elec_16x17.5
SMBJ33A | D5 | D_SMB
MANAGER | J1 | PinHeader_1x20_P2.54mm_Vertical
E-STOP NC (jumper if absent) | J2 | PinHeader_1x02_P2.54mm_Vertical
SLOT0 XT60PW-F | J10 | XT60PW-F | C428722
SLOT1 XT60PW-F | J11 | XT60PW-F | C428722
SLOT2 XT60PW-F | J12 | XT60PW-F | C428722
SLOT3 XT60PW-F | J13 | XT60PW-F | C428722
SLOT4 XT60PW-F | J14 | XT60PW-F | C428722
SLOT5 XT60PW-F | J15 | XT60PW-F | C428722
SLOT6 XT60PW-F | J16 | XT60PW-F | C428722
SLOT7 XT60PW-F | J17 | XT60PW-F | C428722
SLOT0 SIG | J20 | PinHeader_1x08_P2.54mm_Vertical
SLOT1 SIG | J21 | PinHeader_1x08_P2.54mm_Vertical
SLOT2 SIG | J22 | PinHeader_1x08_P2.54mm_Vertical
SLOT3 SIG | J23 | PinHeader_1x08_P2.54mm_Vertical
SLOT4 SIG | J24 | PinHeader_1x08_P2.54mm_Vertical
SLOT5 SIG | J25 | PinHeader_1x08_P2.54mm_Vertical
SLOT6 SIG | J26 | PinHeader_1x08_P2.54mm_Vertical
SLOT7 SIG | J27 | PinHeader_1x08_P2.54mm_Vertical
VBUS+ LUG M6 | J30 | MountingHole_6.4mm_M6_Pad_TopBottom
RETURN LUG M6 | J31 | MountingHole_6.4mm_M6_Pad_TopBottom
1K | R1 | R_0603_1608Metric
120R slot0-end | R2 | R_0603_1608Metric
120R slot7-end | R3 | R_0603_1608Metric
0m5 3920 | RS1,RS2 | R3920_BVS | C466580
INA228 | U1 | VSSOP-10_3x3mm_P0.5mm | C5214669
