udaravima/Lab_Bench/hardware/phase3-manager/bom/phase3-manager-bom.csv

Item | Qty | References | Value | Footprint | LCSC | MPN | Manufacturer | Unit USD | Ext USD | Note
1 | 1 | BZ1 | MLT-8530 | labbench:MLT-8530 | C781886 | YX-SMD8530P | Yuexin | 0.39 | 0.39 | 5 V-rated (2-5 V) drop-in for the 3.6 V MLT-8530; vendor land is identical, pad 1 (+) in the same corner
2 | 2 | C50 C51 | 4.7u/50V | Capacitor_SMD:C_1210_3225Metric
3 | 9 | C52 C65 C66 C69 C70 C73 C74 C75 C76 | 100n | Capacitor_SMD:C_0603_1608Metric
4 | 2 | C53 C68 | 1u | Capacitor_SMD:C_0603_1608Metric
5 | 2 | C54 C55 | 22u/16V | Capacitor_SMD:C_1210_3225Metric
6 | 1 | C56 | 10u/16V | Capacitor_SMD:C_1210_3225Metric
7 | 1 | C57 | 22u/10V | Capacitor_SMD:C_1210_3225Metric
8 | 1 | C64 | 10u | Capacitor_SMD:C_1210_3225Metric
9 | 1 | D5 | SMBJ33A | Diode_SMD:D_SMB
10 | 1 | D7 | LED_STAT | LED_SMD:LED_0603_1608Metric
11 | 1 | D8 | LED_CAN | LED_SMD:LED_0603_1608Metric
12 | 1 | D9 | 1N4148W | Diode_SMD:D_SOD-323
13 | 1 | ENC1 | EC11 | Rotary_Encoder:RotaryEncoder_Alps_EC11E-Switch_Vertical_H20mm | C255515 | EC11E18244A5 | Alps Alpine | 2.4 | 2.4 | EC11E with push switch; EasyEDA land A/B/C + D/E switch + 2 lugs matches the EC11E-Switch footprint
14 | 1 | F1 | 2A mini blade | Fuse:Fuse_Blade_Mini_directSolder | C151091 | 0297002.WXNV | Littelfuse | 0.11 | 0.11 | 2 A MINI blade fuse, soldered directly into the land (no holder)
15 | 1 | J1 | BACKPLANE | Connector_PinHeader_2.54mm:PinHeader_1x20_P2.54mm_Vertical
16 | 1 | J3 | USB-C | Connector_USB:USB_C_Receptacle_GCT_USB4105-xx-A_16P_TopMnt_Horizontal | C3020560 | USB4105-GF-A | Global Connector Technology | 1.3 | 1.3 | stocked at JLCPCB assembly, not LCSC retail; backup USB4105-GF-A-120 C5184243
17 | 1 | J4 | UART | Connector_PinHeader_2.54mm:PinHeader_1x03_P2.54mm_Vertical
18 | 1 | J5 | PANEL KEYS | Connector_PinHeader_2.54mm:PinHeader_1x09_P2.54mm_Vertical
19 | 1 | J6 | ILI9341 LCD MODULE | Connector_PinHeader_2.54mm:PinHeader_1x14_P2.54mm_Vertical |  |  |  |  |  | ILI9341+XPT2046 2.8in module plugs here - AliExpress, confirm 3V3-VCC jumper
20 | 1 | L2 | 33u/1.2A | Inductor_SMD:L_1210_3225Metric
21 | 3 | Q8 Q9 Q10 | 2N7002 | Package_TO_SOT_SMD:SOT-23
22 | 1 | Q11 | AO3401A-class PMOS | Package_TO_SOT_SMD:SOT-23
23 | 1 | R50 | 100K 1% | Resistor_SMD:R_0603_1608Metric
24 | 1 | R51 | 24.9K 1% | Resistor_SMD:R_0603_1608Metric
25 | 4 | R52 R71 R73 R98 | 100K | Resistor_SMD:R_0603_1608Metric
26 | 2 | R62 R63 | 4.7K | Resistor_SMD:R_0603_1608Metric
27 | 25 | R64 R65 R66 R72 R75 R76 R77 R78 R79 R80 R81 R82 R83 R84 R85 R86 R87 R90 R91 R92 R93 R94 R95 R96 R97 | 10K | Resistor_SMD:R_0603_1608Metric
28 | 2 | R67 R68 | 5.1K | Resistor_SMD:R_0603_1608Metric
29 | 2 | R69 R70 | 1K | Resistor_SMD:R_0603_1608Metric
30 | 1 | SW1 | RESET | Button_Switch_SMD:SW_SPST_TL3342
31 | 1 | SW2 | BOOT | Button_Switch_SMD:SW_SPST_TL3342
32 | 1 | U8 | LMR36015AQRNXRQ1 | labbench:LMR36015_RNX_VQFN-HR-12 | C1850345 | LMR36015ARNXR | TI | 1.91 | 1.91 | symbol value says LMR36015AQRNXRQ1 (automotive); SOURCING picked the commercial ARNXR, same RNX package
33 | 1 | U9 | NCP1117-3.3 | Package_TO_SOT_SMD:SOT-223-3_TabPin2 | C26537 | NCP1117ST33T3G | onsemi | 0.21 | 0.21
34 | 1 | U10 | ESP32-S3-WROOM-1-N8R2 | RF_Module:ESP32-S3-WROOM-1 | C2913204 | ESP32-S3-WROOM-1-N8R2 | Espressif | 5.01 | 5.01
35 | 1 | U11 | TCAN1042HGV | Package_SO:SOIC-8_3.9x4.9mm_P1.27mm | C485806 | TCAN1042VDRQ1 | TI | 0.57 | 0.57 | symbol value says TCAN1042HGV; SOURCING picked the V (VIO) variant, same SOIC-8 pinout
36 | 1 | U12 | TPD2E001 | Package_TO_SOT_SMD:Texas_R-PDSO-N5_DRL-5 | C150526 | TPD2E001DRLR | TI | 0.16 | 0.16
37 | 1 | U13 | TCA9535PWR | Package_SO:TSSOP-24_4.4x7.8mm_P0.65mm | C130204 | TCA9535PWR | TI | 0.44 | 0.44 | UMW clone acceptable here
 | 80 |  |  |  |  |  |  |  | 12.5 | 10/80 placements have an LCSC number; total covers those only (qty-1, SOURCING.md 2026-07-18)
