udaravima/Lab_Bench/hardware/phase3-manager/tools/run_drc.py

"""Run DRC on the generated board (KiCad 7: no CLI drc, use pcbnew API).

Usage: python3 run_drc.py [board.kicad_pcb]
Prints a violation-type summary + details, exits 1 on any error-severity
violation or unconnected item.
"""
import os
import re
import sys
from collections import Counter

# KiCad's global fp-lib-table refers to ${KICAD7_FOOTPRINT_DIR}; that var is
# only set by the KiCad GUI, so a headless run cannot expand the library
# URIs and reports every footprint as "not found in library" — 39 phantom
# lib_footprint_issues on the backplane alone. Set it before importing
# pcbnew so DRC compares against the real libraries.
import os as _os
_os.environ.setdefault("KICAD7_FOOTPRINT_DIR", "/usr/share/kicad/footprints")
_os.environ.setdefault("KICAD7_SYMBOL_DIR", "/usr/share/kicad/symbols")

import pcbnew

HERE = os.path.dirname(os.path.abspath(__file__))
BOARD = sys.argv[1] if len(sys.argv) > 1 else os.path.join(HERE, "..", "phase3-manager.kicad_pcb")
RPT = os.path.join(HERE, "..", "drc-report.txt")


def main():
    board = pcbnew.LoadBoard(BOARD)
    pcbnew.ZONE_FILLER(board).Fill(board.Zones())
    pcbnew.WriteDRCReport(board, RPT, pcbnew.EDA_UNITS_MILLIMETRES, True)
    text = open(RPT).read()
    sections = re.split(r"\*\* (.+?) \*\*", text)
    # sections: [head, name1, body1, name2, body2, ...]
    # Each item is a "[type]: description" line followed by indented detail
    # lines, one of which carries "Severity: error" or "Severity: warning" —
    # so grab the whole chunk up to the next item, not just the first line.
    item_re = re.compile(r"\[(\w+)\]: (.+?)(?=\n\[|\Z)", re.S)
    counts = {}
    for i in range(1, len(sections) - 1, 2):
        name, body = sections[i], sections[i + 1]
        counts[name] = [(m.group(1), m.group(2))
                        for m in item_re.finditer(body)]

    errors = 0
    for name, items in counts.items():
        print(f"{name}: {len(items)}")
        for typ, n in Counter(t for t, _ in items).most_common():
            print(f"   {typ}: {n}")
        for typ, chunk in items:
            # Unconnected items are always a fail: an unrouted net is not a
            # matter of taste. Everything else fails only at error severity,
            # so cosmetic silk warnings do not gate the board.
            if "unconnected" in name.lower() or "Severity: error" in chunk:
                errors += 1

    # details for placement-relevant problems
    for name, items in counts.items():
        for typ, chunk in items:
            if typ in ("courtyards_overlap", "malformed_courtyard", "shorting_items",
                       "items_not_allowed", "copper_edge_clearance"):
                print(f"  !{typ}: {chunk.splitlines()[0][:120]}")

    if errors:
        print(f"FAIL: {errors} error-severity/unconnected item(s). The board "
              f"is routed (2026-09-27), so any of these is a regression.")
    else:
        print("PASS: no error-severity violations, no unconnected items.")
    sys.exit(1 if errors else 0)


if __name__ == "__main__":
    main()
