udaravima/Lab_Bench/(commit log)

2026-07-13 Phase 0: design documentation for 8-channel modular PSU
    System architecture, 600W module design, CAN protocol, protection
    matrix, phased build plan, and worked circuit values for the 150W
    Phase-1 prototype (LM5145, FB-injection CV/CC, INA240/INA228 sensing).
2026-07-13 Firmware core: CAN codec + portable module control core, host-tested
    - firmware/common/labbench_can.h: header-only codec for the full
    docs/03 protocol (IDs, payloads, encode/decode), shared with manager
    - firmware/module/core: state machine, envelope clamp, reference-domain
    soft-start, thermal derate/OTP latch, comms-loss policy per docs/03-04
    - firmware/tests: host unit tests (make test), all passing
    - hardware/phase1-module/CAPTURE-GUIDE.md: KiCad sheet plan, net naming,
    grounding plan, ERC checklist for the 150W prototype
2026-07-13 Add initial schematic files and generator scripts for phase1-module
    - Created schematic files for various components: disconnect, io, mcu-can, power-stage, sensing, and added a root schematic for the phase1-module.
    - Implemented a Python script (gen_phase1.py) to generate KiCad schematics with defined connectivity.
    - Added a netlist checking script (check_netlist.py) to validate generated schematics against expected connectivity.
    - Introduced a minimal KiCad generator (kicad_gen.py) to handle symbol definitions and schematic generation.
    - Added a project file (phase1-module.kicad_pro) for KiCad project management.
    [aux-rails.kicad_sch, control-core.kicad_sch, disconnect.kicad_sch, io.kicad_sch, mcu-can.kicad_sch, phase1-module.kicad_sch, power-stage.kicad_sch, sensing.kicad_sch]
2026-07-14 control-core sheet: verified generation, wired runs, clean field placement
    - kicad_gen: pin-bbox-based Reference/Value placement, wire support,
    outward-rotated labels, synthesized power ports, hidden flag text
    - gen_phase1: control-core rows rewired (op-amp -> diode-OR -> injection
    as real wires with on-wire labels), collision fixes, DAC decoupling moved
    - Netlist assertions pass 22/22 (check_netlist.py); render inspected
    - docs/06: DAC80502 moved to 3V3 rail (STM32 logic levels), BAT54W SC-70
    pinout notes
    [aux-rails.kicad_sch, control-core.kicad_sch, disconnect.kicad_sch, io.kicad_sch, mcu-can.kicad_sch, phase1-module.kicad_sch, power-stage.kicad_sch, sensing.kicad_sch]
2026-07-14 Vendor library scaffolding + parts download manifest
    - lib/labbench.kicad_sym project library registered via sym-lib-table
    - lib/vendor/ drop zone for Mouser/UL symbol downloads
    - PARTS-TO-DOWNLOAD.md: exact orderables, packages, verify-list
    - docs/datasheets/ gitignored (PDFs stay local, off the public repo)
2026-07-14 Ignore KiCad lock/autosave files
2026-07-14 Vendor symbols vetted against datasheets and merged into project lib
    - All 5 pin maps verified: LM5145RGYR (incl. odd pin-15 'EP' - real per
    RGY pinout), TCAN1042HGVDR, INA228AIDGSR, TLV7011DBVR,
    LTC7004EMSE#TRPBF (MSOP-10 correction, was listed MSOP-8)
    - tools/merge_vendor.py: merges only VETTED symbols, records what each
    was checked against
    - kicad_gen: project-lib search path, SnapMagic flat-pin fallback
    - Regression: control-core netlist still 22/22
    [aux-rails.kicad_sch, control-core.kicad_sch, disconnect.kicad_sch, io.kicad_sch, mcu-can.kicad_sch, phase1-module.kicad_sch, power-stage.kicad_sch, sensing.kicad_sch]
2026-07-14 Two part disqualifications caught by exact-variant spec check
    - OPA2189 -> OPA2333: OPAx189 input common-mode range stops ~2.5V below
    V+, colliding with our 2.5V full-scale signals on the 5V rail
    - TPS54202 -> LMR36015: 28V Vin(max) is inside the 24-30V bus spec;
    60V part restores margin
    - DAC80502 footprint pinned to VSSOP-10 (DGS), exact orderables for all
    section-B parts in PARTS-TO-DOWNLOAD.md (incl. STM32G431CBT6 + RM0440)
    [aux-rails.kicad_sch, control-core.kicad_sch, disconnect.kicad_sch, io.kicad_sch, mcu-can.kicad_sch, phase1-module.kicad_sch, power-stage.kicad_sch, sensing.kicad_sch]
2026-07-14 DAC80502 straps verified and applied; two package corrections
    - SPI2C strapped to AGND (low = SPI mode, ds 8.5.1); RSTSEL low =
    zero-code POR confirmed - both now hardwired in control-core
    - DAC80502 is WSON-10 (DRX) only; VSSOP/DGS was the DAC80501 single.
    Footprint reverted, Value = DAC80502DRXT
    - LMR36015 is VQFN-HR-12 (RNX), not HSOIC-8; AQRNXRQ1 variant vetted
    (adjustable, 400 kHz, non-FPWM) and merged for the aux-rails sheet
    - Netlist: 21 nets pass (DAC_SPI2C net absorbed into AGND)
    [aux-rails.kicad_sch, control-core.kicad_sch, disconnect.kicad_sch, io.kicad_sch, mcu-can.kicad_sch, phase1-module.kicad_sch, power-stage.kicad_sch, sensing.kicad_sch]
2026-07-15 Complete Phase-1 schematic: all six remaining sheets, netlist-verified
    - power-stage: LM5145 @350kHz (RT 28.7K per ds eq.3), RDS(on) valley
    ILIM 365R->SW, UVLO divider, EN kill chain (NOT(HW_EN) OR PS_OFF via
    Q5/Q6 + diode-OR), Type-III comp starting values, SYNCIN as DEM/FPWM
    - sensing: 2m shunt, INA240A3 -> CC loop, INA228 telemetry, /8 divider,
    NT1 single AGND-PGND tie
    - disconnect: back-to-back FETs + LTC7004, INP = OUT_REQ AND NOT(kill)
    AND NOT(OVP); TLV7011 + Q9 trips at 22.25V
    - aux-rails: LMR36015 (5.016V) -> NCP1117 3V3
    - mcu-can: STM32G431CBT6 fully pinned; I2C moved to I2C2/PA8-PA9 (PB8
    is the BOOT0 strap - pullup there would boot the ROM loader), BOOT0
    strapped low, O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
    [aux-rails.kicad_sch, control-core.kicad_sch, disconnect.kicad_sch, io.kicad_sch, mcu-can.kicad_sch, phase1-module.kicad_sch, power-stage.kicad_sch, sensing.kicad_sch]
2026-07-15 Footprint pass: labbench.pretty library, all 137 components verified
    - build_fplib.py: merges vetted vendor footprints (LM5145 RGY0020B,
    LMR36015 RNX, DAC80502 WSON-10 no-EP) and generates PowerFET_SON5x6_GDS
    from the TI Q5A land pattern (CSD18563Q5A SLPS444C) with pads renumbered
    1=G/2=D/3=S to match the generic NMOS symbol; writes fp-lib-table.
    - check_footprints.py: every component must have a resolvable footprint and
    every netted pin a matching pad (caught a wrong official VSSOP-8 name).
    - gen_phase1.py: passives 0402->0603 (hand assembly); DAC80502 vendor fp
    (DRX has no exposed pad); L1 = Coilcraft XAL1350-103ME on official fp;
    net-tie fp; crystal -> Crystal_GND24 with groun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
    [aux-rails.kicad_sch, control-core.kicad_sch, disconnect.kicad_sch, io.kicad_sch, mcu-can.kicad_sch, phase1-module.kicad_sch, power-stage.kicad_sch, sensing.kicad_sch]
2026-07-15 PCB placement v1 + kicad-happy audit fixes
    gen_board.py: netlist-driven board generator (120x80 4-layer) — placement
    table for all 137 components, split In1 ground plane (PGND/AGND star at
    NT1, AGND pocket under the LTC7004 cluster), In2 5V0/3V3 distribution,
    9 F.Cu power pours with straddled cap banks, mechanical checks (pad-in-pour
    assertions, courtyard overlap/edge detection). run_drc.py wraps pcbnew
    WriteDRCReport (KiCad 7 has no CLI drc).
    Audit (kicad-happy analyzers: schematic+PCB+cross+EMC+thermal) fixes:
    - R31 100R -> 1K: INA240 rails at ~4.8V on the 5V rail during OC transients;
    PA1 is TT_a (3.6V) — 100R allowed ~12mA clamp injection vs 5mA abs max
    - C43 moved to decouple U7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
    [aux-rails.kicad_sch, control-core.kicad_sch, disconnect.kicad_sch, io.kicad_sch, mcu-can.kicad_sch, phase1-module.kicad_pcb, phase1-module.kicad_sch, power-stage.kicad_sch]
2026-07-15 Routing pass 1: power copper, vias, critical routes — 0 copper DRC violations
    route_board.py (deterministic pass after gen_board.py):
    - In2.Cu same-net heat patches under all six F.Cu power pours; thermal via
    arrays on Q1-Q4 tabs and L1 pads (heat + current into the inner layer)
    - EP vias (LM5145, LTC7004), NT1 star-tie vias, J1/J4 PGND clusters,
    PGND_TOP/bar plane ties, 86 seam-aware power-pad vias (plane checked at
    the via position, dedup against existing same-net vias), 63 stitches
    - critical routes: true-Kelvin sense pair (shunt inner edges -> INA240 ->
    INA228, routed around the amp, 0.24-0.3mm), LM5145 right-column fan-out
    (0.5mm pitch escapes at exact-clearance widths), HO/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
    [phase1-module.kicad_pcb]
2026-07-15 Pause PCB layout: defer board design to end of all phases
    autoroute.py committed as WIP tooling (grid A* router, 154/187 routed at
    last run; status + known issues in its header). Board file stays at the
    clean routing-pass-1 state — regenerate with gen_board.py + route_board.py.
    README updated with the new plan and verified build pricing (~US$100-125).
    [autoroute.py]
2026-07-15 Module firmware v0.1: bare-metal STM32G431 binding for module_core
    No vendor HAL — register-level against vendored CMSIS headers (Apache-2.0,
    provenance in cmsis/README.md). Builds with arm-none-eabi-gcc 14 (Makefile
    auto-finds the xPack install), 6.3 KB flash, -Wall -Wextra -Werror clean.
    - clocks: HSE 8 MHz -> PLL 96 MHz (range 1, no boost, 3 WS); FDCAN kernel
    from raw HSE for crystal-accurate 500 kbit timing; I2C2 from HSI16
    - board.h: pin map mirrors the netlist-verified schematic; scaling constants
    from docs/06 (V 6429 uV/ct, I 4028 uA/ct, DAC 2.5 V FS mappings); NTC
    B3950 lookup table
    - drivers: polled ADC1/ADC2 scan, DAC80502 (SPI mode 1, REF/2 x gain2),
    INA228 (ADCRANGE=1,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
    [adc.c, board.h, dac80502.c, drv.h, fdcan.c, flash_cal.c, ina228.c, main.c]
2026-07-16 Documentation set + session handover
    - docs/07-module-firmware.md: firmware architecture, pin map, scaling,
    control flow, bring-up checklist, known-untested surface
    - hardware/phase1-module/tools/README.md: generation/verification pipeline,
    full-rebuild recipe, pcbnew 7 API traps (measured, not guessed)
    - PARTS-TO-DOWNLOAD.md section E: LCSC-verified pricing snapshot + totals
    - HANDOVER.md: project state, working agreement, load-bearing design
    decisions with the trap each avoids, open items, tooling quirks —
    written for another agent/session to continue seamlessly
    - README.md: restructured with documentation index and current status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
2026-07-16 Phase-2 600 W circuit design (docs/08): all values worked + verified
    - LM5143 single-output interleaved config verified (MODE=VDDA, FB2=AGND,
    COMP/SS tied, FB threshold 0.6 V, VCCX from 5 V aux); RT 63.4 k -> 347 kHz
    - Inductor corrected 4.7 uH -> 6.8 uH (XAL1510-682ME, Isat 36 A verified):
    internal slope comp fails Ridley criterion with 4.7 uH at D -> 0.93
    - INA240A4 -> A3: gain 200 would cap the CC loop at 25 A against the
    DAC80502's 2.5 V full scale (docs/02 latent bug, fixed there too)
    - Per-phase 3.5 mOhm shunt sensing (phase-balance criterion kills DCR
    sensing); tolerance-stack no-false-trip margin checked at 66 mV min
    - LM5069-2 hot-swap front end fully sized: 1.5 mOhm sense,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
2026-07-16 Factor shared sheets + checkers into hardware/common for Phase-2 reuse
    - hardware/common/kicad_gen.py (moved from phase1 tools; project lib dirs
    now registered via add_lib_dir so both phases share one library)
    - hardware/common/sheets_common.py: control-core, sensing, disconnect,
    aux-rails, mcu-can extracted verbatim as parameterized builders (docs/05:
    control core reused as a hierarchical block); phase-specific values are
    parameters, refs and topology unchanged
    - hardware/common/netcheck.py: netlist/footprint assertion logic shared;
    per-project check_*.py become thin CLI wrappers
    - gen_phase1.py passes Phase-1 parameter sets; power-stage and io stay local
    - Verified: regenerated P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
    [aux-rails.kicad_sch, control-core.kicad_sch, disconnect.kicad_sch, io.kicad_sch, mcu-can.kicad_sch, phase1-module.kicad_sch, power-stage.kicad_sch, sensing.kicad_sch]
2026-07-16 Phase-2 600 W module schematic: 8 sheets, 171 components, machine-verified
    Draws docs/08 as hardware/phase2-module (gen_phase2.py):
    - hot-swap: LM5069-2 front end (1.5m sense, CSD19536KTT D2PAK, UVLO
    10.5/9.5V, OVLO 33.1/31.8V, P_LIM 100W, CT 100n); PGD gates the aux-buck
    EN so the load stays off during linear inrush - the MCU reads AUX_PG,
    the planned PC13 PGD input didn't survive level-shift analysis (docs/08
    s.3/s.11 amended)
    - power-stage: LM5143 single-output interleaved (MODE=VDDA, FB2=AGND,
    COMP/SS tied), 347kHz (RT 63.4K), 4x CSD18540Q5B, 2x XAL1510-682ME,
    3.5m phase shunts, VCCX from 5V0, DEMB pulldown = DEM default, hiccup +
    dither fitted, Type-II gm-EA comp starting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
    [aux-rails.kicad_sch, control-core.kicad_sch, disconnect.kicad_sch, hot-swap.kicad_sch, io.kicad_sch, mcu-can.kicad_sch, phase2-module.kicad_sch, power-stage.kicad_sch]
2026-07-17 Phase-2 schematic audit: analyzer triage clean, ngspice 45/47 pass
    kicad-happy schematic analyzer (117 findings) triaged against the audited
    Phase-1 baseline:
    - VM-001 x8 (5V/3.3V crossings): all false positives or known-mitigated -
    CAN_* (TCAN1042 VIO variant), DROOP_EN (TMUX1101 VIH<=1.49V verified),
    PS_FPWM (DEMB VIH 2V), PS_PGOOD (open-drain + 3V3 pull-up), I_MEAS
    (R31 1K injection limit, the Phase-1 fix), V_MEAS (divider-bounded 2.5V)
    - FS-001 "FB divider too low-Z" = the injection scheme by design
    - PU-001 MODE strap = datasheet-prescribed direct VDDA tie
    - RS-001 set identical to Phase-1 audited baseline (analyzer never sees
    PWR_FLAG symbols); SS-001/DS-003 = MPN pass deferred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
2026-07-17 Phase-3 circuit design (docs/09): backplane + ESP32-S3 manager
    - Backplane: near-passive by design (only IC = bus-entry INA228 on 250uOhm
    high-side bar shunt, 3.3x range headroom at the 200A ceiling); fail-safe
    /HW_ENABLE chain (pull-up current flows THROUGH the NC E-stop switch, so
    a broken wire or unplugged manager = all modules SAFE, levels checked
    against 8x 100k module pulldowns); 120R CAN ends; slot straps encoded
    per firmware convention; PRESENT lines routed raw to the manager
    - Manager: ESP32-S3-WROOM-1-N8R2 (quad PSRAM keeps IO35-37 - octal loses
    them, ds note b), full GPIO map incl. strap-pin hygiene; TCA9535 for
    8 PRESENT + 8 keys (no internal pull-ups - 16 external)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
2026-07-17 Phase-3 schematics: 8-slot backplane + ESP32-S3 manager, machine-verified
    phase3-backplane (gen_backplane.py, 29 components):
    - lugs -> 250uOhm bar shunt (placeholder fp) -> INA228 high-side bus meter
    - fail-safe E-stop: 3V3 through the NC switch -> 1K -> HW_EN
    - 120R CAN terminations at both physical ends; manager is a stub
    - slot-ID straps hardwired per the FIRMWARE convention (grounded = bit set,
    all-open = slot 0); EXPECTED_NETS uses EXACT assertions (no supersets) so
    a mis-strapped pin cannot hide as an allowed extra in PGND
    phase3-manager (gen_manager.py, 78 components, 3 sheets):
    - power-can: vetted LMR36015->5V0->NCP1117->3V3 chain (single ground),
    TCAN1042HGV stub, 2N7002 E-s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
    [mcu.kicad_sch, phase3-backplane.kicad_sch, phase3-manager.kicad_sch, power-can.kicad_sch, ui.kicad_sch]
2026-07-17 Phase-3 schematic audit: real find fixed (manager I2C pull-ups), SPICE clean
    The analyzer caught a genuine capture omission: docs/09 s.3 specifies 4.7K
    I2C pull-ups on the manager (it owns the bus feeding TCA9535 + the
    backplane INA228), but gen_manager.py never drew them - and EXPECTED_NETS,
    written from the same plan, shared the blind spot. R62/R63 added, all
    checkers re-verified green (80 components).
    Triage of the rest:
    - backplane PR-001/PU-001 "missing I2C pull-ups": by design, manager owns
    them (docs/09); U1 ALERT unused open-drain, no pull needed
    - RS-001: PWR_FLAG-invisible analyzer class (accepted since Phase-1)
    - SS-001/DS: MPN pass deferred to the batch BOM stage as before
    ngs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
    [mcu.kicad_sch, phase3-manager.kicad_sch, power-can.kicad_sch, ui.kicad_sch]
2026-07-17 Manager firmware v0.1: host-tested core + docs/10 + ESP-IDF skeleton
    firmware/manager/core (module_core pattern: C99, no HAL/floats/allocation,
    frames in / TX ring out, reuses labbench_can.h verbatim):
    - discovery via HELLO (a re-HELLO = module reboot: our view resets to OFF)
    - STATUS heartbeat supervision, >1s = lost + excluded from budget (#15)
    - SET_VI ack = next STATUS echoing the setpoints; 50ms retry x3 then
    unresponsive (docs/03 s.3)
    - budget arbiter (#17): committed = sum of max(measured, commanded) per
    usable channel; refuses enables AND raises; OFF always granted
    - charge sequencer (docs/03 s.7): LIMITS(policy=hold) -> SET_VI ->
    OUTPUT(on+DEM); RAMP->CC->CV->TERM_WAIT->DONE;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
    [app_main.c]
2026-07-17 China-first sourcing pass: LCSC prices verified, inductor+shunt change applied
    hardware/SOURCING.md: full LCSC pass (jlcsearch API + JLCPCB part pages)
    for all four boards - user imports from China to Sri Lanka, so LCSC/JLCPCB
    consolidated shipping is now the primary path (Mouser only for what China
    cannot do). Phase-3 build parts ~= $135; all-in with PCBs ~= $300-380.
    Engineering decisions (user-approved):
    - Inductor: Sunlord MWSA1707S-6R8MT ($1.72; 17A Irms / 22A Isat verified
    via JLCPCB) + 2x XAL1510-682 spares for an A/B thermal test. Bourns
    SRP1265A-6R8M REJECTED (18A/11.5A) and Sunlord MWSA1265S-100MT REJECTED
    for Phase-1 (12A/7.5A) - both the same Isat-trap class as the XAL1350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
    [aux-rails.kicad_sch, control-core.kicad_sch, disconnect.kicad_sch, hot-swap.kicad_sch, io.kicad_sch, mcu-can.kicad_sch, phase2-module.kicad_sch, power-stage.kicad_sch]
2026-07-18 Apply China-sourcing engineering changes across all boards + mechanical frame
    All datasheet-verified before application (details hardware/SOURCING.md sF):
    - TMUX1101 -> TS5A3166DBVR (LCSC availability; ts5a3166.pdf: pin POSITIONS
    identical - 1=NO 2=COM 3=GND 4=IN 5=V+; VIH 2.4V ok from 3.3V GPIO)
    - TLV7011 DBVR -> DCKR: tlv7022.pdf shows DBV/DCK share one pinout, so
    footprint-only (SOT-353_SC-70-5); SOT-23-5 stock in China is nearly gone
    - crystal load caps 10p -> 18p, both phases (CL=12pF China crystals; the
    HANDOVER-blessed alternative to hunting CL=8pF parts)
    - Phase-1 inductor -> MWSA1707S-100MT (JLCPCB-verified 16.5A Isat/10.5A
    Irms vs 12A/8A required); value strings now dual-so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
    [aux-rails.kicad_sch, control-core.kicad_sch, disconnect.kicad_sch, hot-swap.kicad_sch, io.kicad_sch, mcu-can.kicad_sch, mcu.kicad_sch, phase1-module.kicad_sch]
2026-07-18 Footprint pass: China-part land patterns generated, placeholders retired
    build_fplib.py sourcing_footprints() - geometry vetted from LCSC/EasyEDA
    library pulls (easyeda2kicad), encoded in code like the PowerFET precedent
    so regeneration needs no network:
    - XT60PW-M / XT60PW-F: power pins 3.8mm pads / 2.9-2.8mm drills @ 7.2mm
    pitch + 0.6x1.6 retention slots. The -F library pull had the RETENTION
    LEGS numbered as pads 1,2 - power pads renumbered to 1,2 to match the -M
    and the Conn_01x02 symbol (a trap no netlist check would ever catch)
    - L_1707_XAL1510: SUPERSET pad 5.39x13.2 @ +/-6.405 covering Sunlord
    MWSA1707S (3.5x12.8 @ 7.35) and Coilcraft XAL1510 (3.18x13.2 @ 5.3) -
    the A/B the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
    [aux-rails.kicad_sch, control-core.kicad_sch, disconnect.kicad_sch, hot-swap.kicad_sch, io.kicad_sch, mcu-can.kicad_sch, mcu.kicad_sch, phase1-module.kicad_sch]
2026-07-18 Add autosaved schematic files for power stage and auxiliary rails in phase2-module
    [aux-rails.kicad_sch, control-core.kicad_sch, disconnect.kicad_sch, hot-swap.kicad_sch, io.kicad_sch, mcu-can.kicad_sch, phase2-module.kicad_sch, power-stage.kicad_sch]
2026-07-18 Refactor code structure for improved readability and maintainability
    [aux-rails.kicad_sch, control-core.kicad_sch, disconnect.kicad_sch, io.kicad_sch, mcu-can.kicad_sch, power-stage.kicad_sch]
2026-07-19 Update aux-rails schematic and phase2-module project settings; add 5V0 power symbol and adjust component placements
    [aux-rails.kicad_sch]
2026-07-20 Add routing and DRC scripts for phase 2 module
    - Implemented `route_board.py` to handle routing for the phase 2 module, including In2 patches, vias, and critical hand routes.
    - Introduced `run_drc.py` to perform Design Rule Checks (DRC) on the generated board, providing a summary of violations and unconnected items.
    [phase2-module.kicad_pcb]
2026-07-25 Phase-2 copper pass-1 to 0 DRC; backplane board complete; autorouter
    Phase-2 module (130x90 4L):
    - route_board.py: clear the last 3 copper clusters (U6 rot-180 stubs,
    U3 gate fan-out incl. the CS2 chain that was attached to pin 3
    instead of pin 4, U5 sense via-on-pad, R32 clip) -> 0 copper DRC,
    0 mask/hole/dangling. 238 unconnected = signal nets for autoroute.
    - autoroute.py: phase-1 router with its fix list applied (net-blind
    via hole spacing, plane targets from in1/in2 maps) on a 0.125 mm
    bytearray grid after the 0.25 mm grid proved unable to hit the
    0.185 mm-wide legal lanes at the fine-pitch escapes.
    Phase-3 backplane (330x100 2L 2oz): single-script gen_board.py,
    fully place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
    [phase2-module.kicad_pcb, phase3-backplane.kicad_pcb]
2026-07-25 HANDOVER: first 0.125mm autoroute run results (238->88 unconnected)
    Records the four known issues for the next routing session: connected-pad
    false fails, entry-stub clipping at 0.5mm-pitch pins, two dangling
    slivers, and the plane-map scan perf fix. Board file stays at the clean
    committed copper-pass-1 state; autoroute output intentionally uncommitted.
2026-07-25 Manager fw v0.2 (SCPI+UI cores host-tested, full IDF shell); P2 router fixes
    Firmware: scpi_core (docs/01 §6 grammar, integer micro-unit math, error
    FIFO, budget refusals as -221) and ui_core (40x15 text-model screens:
    list/detail/digit-edit/system, key toggles, fault-edge beeps) join
    manager_core as host-tested cores — test_scpi.c + test_ui.c green in
    firmware/tests. IDF shell filled in: display.c (esp_lcd ILI9341, VGA
    8x16 font machine-extracted by tools/gen_font.py), encoder.c (PCNT x4
    quadrature, push/hold), scpi_usb.c (TinyUSB CDC), integrated app_main.c
    (one-mutex locking, TCA9535 keys, backplane INA228 bus meter: 250 uOhm,
    CURRENT_LSB 400 uA, SHUNT_CAL 1311), idf_component.yml. She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
    [app_main.c, autoroute.py, board_pins.h, display.c, display.h, encoder.c, encoder.h]
2026-07-25 Phase-2 board back to the clean pass-1 copper baseline (0 copper DRC)
    Regenerated deterministically (gen_board.py + route_board.py) so the
    tracked board is again the state HANDOVER intends to carry: placement,
    pours, In2 patches, all pass-1 hand routes -- 0 clearance, 0 dangling,
    0 shorts; 240 unconnected = the signal nets, untouched by any router.
    This supersedes the autoroute output that 3da24a7 committed by accident
    (88 unconnected but 4 clearance errors + 2 dangling slivers, from the
    pre-fix router). Router output stays out of the tree until a run
    converges; every intermediate is reproducible from the two generators.
    Also ignores transient layout artifacts: tools/logs/ (freerouting) an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
    [phase2-module.kicad_pcb]
2026-07-25 Phase-2: Freerouting round-trip tooling, PS-002 checker, 2 stitch vias
    check_planes.py — PS-002 in the layout loop instead of only in an
    analysis run. Counts islands per filled zone from KiCad's own filler,
    then asks the question the raw island count does not: does the island
    hold pads, and does it contain a via/PTH of its own? First two drafts
    over-reported (bbox containment, then "no tie = break"); corrected to
    real point-in-polygon plus an honest verdict — KiCad's connectivity
    says these pads ARE connected, so a tie-less island is a return-path
    quality item, not an electrical break. Reports board-relative coords.
    Result on the pass-1 board: 2 F.Cu PGND islands (3 pads each) reached
    g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
    [check_planes.py, export_dsn.py, import_ses.py, route_board.py]
2026-07-25 Phase-2: fabrication output plotter (gerbers + drills), guarded
    gen_gerbers.py plots the 11 JLCPCB-flavoured layers, merged PTH/NPTH
    Excellon and a drill map into fab/, then zips them. RS-274X without X2
    attributes and without Protel extensions — what JLC's parser wants.
    It refuses to run while anything is unconnected, because a gerber set of
    a half-routed board is the classic way to fab a paperweight; --force is
    there for a deliberate fit check and labels the output NOT fab-ready.
    Verified end to end on the current (unrouted) board with --force before
    trusting it: Edge_Cuts measures exactly 130.00 x 90.00 mm, all four
    copper layers plot with content, 278 drill hits. Output is gitignored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
2026-07-25 Phase-2 board: autoroute + silk pass — 240 -> 83 unconnected, 0 copper DRC
    Full deterministic pipeline (gen_board -> route_board -> autoroute ->
    silk_refs) with the rebuilt router:
    unconnected 240 -> 83 (164 nets routed, 69 escapes refused)
    clearance 0 (stays clean: no shorts, no dangling)
    silk 154 -> 11 (160/180 refdes placed clean, 20 best-effort)
    DRC total 334 -> 191 (180 = the known-benign lib bookkeeping)
    The 83 remaining split as ~35 items on plane nets (AGND 16, 5V0 9, PGND 7,
    3V3 3 — pour-fragment stubs, a few vias each) and ~48 real signal escapes
    clustered at U3's control pins and U10's QFN, which is where a grid maze
    rout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
    [phase2-module.kicad_pcb]
2026-07-25 HANDOVER: Phase-2 resume point rewritten for the hand-routing finish
    Live front is now "83 connections to finish by hand in KiCad", with the
    work broken down (35 plane-net stubs, ~14 at U3's control pins, ~15 at
    U10's QFN, ~19 scattered) and pointed at drc-report.txt for per-item
    coordinates. Recommends interactive push-and-shove rather than more
    batch routing, because that is genuinely the right tool for fine-pitch
    escapes — not a consolation prize.
    Records three things a future session would otherwise rediscover the
    hard way: Freerouting is ruled out with evidence (crash signature with
    zones, jstack-confirmed hang without, plus the untested segment-merging
    hypothesis); PS-002 stitching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
2026-07-26 Backplane fab-ready; DRC "benign bookkeeping" was two real bugs
    The lib_footprint_issues class everyone has been waving through (39
    backplane, 180 phase-2, 144 phase-1) was never one thing, and neither
    half was harmless bookkeeping:
    1. The board generators add footprints by name only, leaving the FPID
    library nickname empty. common/fix_fpids.py resolves each item name
    against the project library first, then the system libraries, and
    writes the nickname back (363 resolved across three boards, none
    guessed — unresolved names are reported, never invented).
    2. KiCad's global fp-lib-table expands ${KICAD7_FOOTPRINT_DIR}, which
    only the GUI sets. Headless DRC could not exp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
    [phase1-module.kicad_pcb, phase2-module.kicad_pcb, phase3-backplane.kicad_pcb]
2026-07-26 HANDOVER: backplane fab-ready, shared tooling, phase-1 count corrected
    Backplane promoted to FAB-READY with its verification numbers recorded
    (Edge_Cuts 330.00x100.00, drill breakdown that cross-checks against the
    M6 lugs / 8 XT60 slots / M3 mounts). Next-steps reordered around what is
    actually blocked: phase-2 hand-routing, then the manager board (the only
    one with no PCB at all), then BOM/order files, then phase-1.
    Documents the lib_footprint_issues finding so nobody waves it through
    again, and moves the XT60 polarity gate out from under phase-1 where it
    had drifted — it gates ordering ANY board, backplane included.
    Phase-1 corrected to 187 unconnected (the 33 came from an uncommitted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
2026-07-26 Phase-3 manager: board created, placement pass-1 at 0 DRC
    The last board with no PCB now has one. 80 footprints, 86 nets, 100x80
    2-layer, placement + planes + silk complete: 0 DRC violations, 173
    unconnected (the signal nets — routing is the next pass).
    Floor plan is driven by U10's antenna. The ESP32-S3-WROOM-1 footprint
    carries a 48 x 21 mm RF keep-out — its courtyard (48 x 41) is far larger
    than the module body (18 x 25.5) — so U10 faces the top edge and most of
    that rectangle hangs off-board. check_keepout() asserts nothing
    conductive enters the on-board remainder, and the fill is verified
    separately: zero filled-copper vertices inside the zone. A ground pour
    quietly flooding a WR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
    [phase3-manager.kicad_pcb]
2026-07-26 Manager board: fix two real defects found by kicad-happy audit
    Ran the audit stack (schematic, PCB --full, cross-domain, EMC, thermal,
    SPICE) that this project uses at milestones but that the new board had
    never seen. It found two genuine layout defects, both introduced while
    iterating placement against courtyard collisions:
    * EMC DC-002 (error): U10 sat 19.3 mm from its own decoupling. Its 3V3
    pin is pad 2 at the module's TOP-left (61.2, 17.0), not the bottom
    where I had assumed; an earlier pass parked C64/C65 at y=36 to clear
    the courtyard. Moved beside the pin — 3.0 mm and 5.5 mm, both still
    clear of the antenna keep-out. Error cleared.
    * EMC SW-003: the buck's input caps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
    [phase3-manager.kicad_pcb]
2026-07-26 Manager 3V3 plane break + five tooling defects, from a 9-commit review
    Reviewed 8010576..9a8feb8 and re-measured every headline number
    independently. The claims hold: phase-1 75 silk/187 unconnected, phase-2 11
    silk/83 unconnected, backplane 0/0, manager 0 DRC; the lib_footprint_issues
    fix is real (0 Footprint errors on every board now) and the phase-1 board
    diff in d9e1a7b was FPID-only, nothing else disturbed. fix_fpids' guessing
    risk is a non-issue here: 13,494 footprint names indexed, 0 in >1 library.
    One real regression, though, and it was in the newest commit.
    MANAGER 3V3 PLANE WAS SEVERED (regression in 9a8feb8)
    Moving C64/C65 beside U10 to clear EMC DC-002 pinched the F.Cu 3V3 pou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
    [phase3-manager.kicad_pcb]
2026-09-27 Add LCSC part numbers to all four boards' schematics and generate BOMs
    common/bom.py writes hidden LCSC/MPN/Manufacturer properties into the
    placed symbols (additive only, both one-line and KiCad multi-line
    property styles) and emits <board>/bom/<board>-bom.csv plus a
    JLCPCB-format CSV. Part table in common/lcsc_parts.py, transcribed
    from SOURCING.md with explicit references per board; CHECK notes flag
    footprint/variant mismatches. --check fails on stale output.
    Claude-Session: https://claude.ai/code/session_01MKtKgebN9BpUrgqHq9t7pT
    [aux-rails.kicad_sch, control-core.kicad_sch, disconnect.kicad_sch, hot-swap.kicad_sch, io.kicad_sch, mcu-can.kicad_sch, mcu.kicad_sch, phase1-module-bom.csv]
2026-09-27 Manager firmware: first ESP-IDF compile, fix two build errors
    The ESP32-S3 manager shell now builds clean on ESP-IDF v5.3.2
    (355 KB app image, zero warnings in main).
    - sdkconfig.defaults: enable CONFIG_TINYUSB_CDC_ENABLED. esp_tinyusb
    ships the CDC class off, so tusb_cdc_acm.h hard-errored in scpi_usb.c.
    - main/CMakeLists.txt: name esp_lcd_ili9341 and esp_tinyusb in REQUIRES
    so display.c/scpi_usb.c resolve their headers with the component
    manager off (local component copies) as well as on.
    - Ignore generated sdkconfig and managed_components/.
    - docs/10, HANDOVER: record the first compile and component versions.
    Cla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
2026-09-27 Phase-1 module board: finish routing (187 -> 0 unconnected), fab zip
    Routes every remaining connection of the 150 W module board with a
    scripted chain on top of the pass-1 copper:
    - fanout.py: placement nudges (C25, C26, R3, R6), hand escapes for
    U3's boxed-in SS/FPWM/FB pins, via drops for plane-net pads, and a
    solid zone join for J2.5 (starved thermal at the board edge)
    - export_dsn.py / import_ses.py: Freerouting 1.9 round trip with the
    In1/In2 planes as power layers and F.Cu pours as keepouts
    - finish_routes.py: exact-geometry A* router with rip-up that closes
    the connections Freerouting leaves open
    DRC: 0 unconnected, 0 errors, 9 silk warnings. The fab zip (gerbers +
    drill) is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
    [phase1-module.kicad_pcb]
2026-09-27 Add GitHub Actions CI: host tests, module and manager firmware builds
    Runs the five host test suites, builds the STM32G431 module firmware
    with Ubuntu's arm-none-eabi-gcc, and builds the ESP32-S3 manager with
    ESP-IDF v5.3.2. Firmware images are uploaded as workflow artifacts.
    Claude-Session: https://claude.ai/code/session_01GayDV6JMjvVbsrqxsaLzXg
2026-09-27 Phase-1 board: fix the three routing review items
    - C28 (PS_VIN 100n) moved onto U3 pin 20: pad 1 lands on the PS_VIN
    feed 0.85 mm from the pin, pad 2 in the PGND bar beside a PGND via.
    PS_VIN copper 24.8 -> 17.7 mm.
    - VBUS divider R60/R61/C62 moved from the far right edge to beside
    U10.14 (ADC), so the long run is the low-impedance VBUS_F side and
    C62 filters next to the pin. High-impedance VBUS_SNS copper
    63.7 -> 19.3 mm; the VBUS_F feed to R60 is 79 -> 61 mm.
    - VOUT_INT FB sense run left as routed: 5.5 mm or more from SW copper
    on every layer, and its long end is the output side of the divider.
    - All part offsets folded into gen_board.py PLACEMENT (C25, C26, R3,
    R6 from the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
    [phase1-module.kicad_pcb]
2026-09-27 Add build guide, Phase-1 bench test procedure and CAN bench helper; refresh README status
    - docs/11-build-guide.md: ordering, assembly, J5 bench harness (HW_EN is
    pulled low on the board), firmware flashing and a staged first power-up.
    - docs/12-phase1-bench-tests.md: calibration and every docs/05 Phase-1 exit
    test, with the probe points the board actually has and two predicted
    gaps (OCP backup alert never configured; OVP does not disable EN or latch).
    - docs/test-results/phase1-results-template.md: record sheet.
    - firmware/tools/lbcan.py: builds cansend frames and decodes candump.
    - README: status table as of 2026-09-27, doc index, layout.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
2026-09-27 Phase-1: JLCPCB pick-and-place (CPL) file
    common/cpl.py writes <board>/bom/<board>-cpl.csv in JLCPCB's columns
    (Designator, Mid X, Mid Y, Layer, Rotation), in the gerbers' frame
    (page mm, Y up). Mid X/Y is the body centre from the Fab outline, so
    headers and terminal blocks are not placed on pin 1. Rotations are
    KiCad's, unmodified, to be checked in JLCPCB's placement preview.
    DNP parts are skipped by the same rule as bom.py, so the CPL and the
    JLCPCB BOM list the same 134 parts.
    Claude-Session: https://claude.ai/code/session_017ZrT5TjsLMQoxTZy1jabew
    [phase1-module-cpl.csv]
2026-09-27 Phase-1 BOM: Q3/Q4 part, hand-solder notes
    Q3/Q4 (output disconnect, 60 V NFET on the SON5x6 GDS land) get the
    same part as Q1/Q2: CSD18563Q5A, LCSC C77239, already verified in
    SOURCING.md for this footprint. The through-hole parts (J1-J6, F1) are
    marked hand-solder in the BOM notes. bom.py --check passes.
    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
    [disconnect.kicad_sch, phase1-module-bom.csv, phase1-module-jlcpcb.csv]
2026-09-27 Phase-1 BOM: LCSC numbers for every assembled part
    Fill the 109 missing Phase-1 placements from the JLCPCB catalogue
    (checked 2026-09-27, Basic parts where one fits), so 127 of 136
    placements carry an LCSC number. J1-J6 and F1 stay hand-solder;
    C17 and R17 are DNP.
    Out-of-stock swaps: Q1-Q4 CSD18563Q5A -> NTMFS5C670NLT1G (SO-8FL,
    same pinout), P1 U5 INA228AIDGSR -> INA228AQDGSRQ1. Y1 moves to the
    CL = 12 pF version of the same crystal (C400090 was the 10 pF one).
    Claude-Session: https://claude.ai/code/session_013uVohQZFdivAh43gw4mZtf
    [aux-rails.kicad_sch, control-core.kicad_sch, disconnect.kicad_sch, io.kicad_sch, mcu-can.kicad_sch, phase1-module-bom.csv, phase1-module-jlcpcb.csv, phase2-module-bom.csv]
2026-09-27 Route the phase-3 manager board: 0 unconnected, 0 DRC errors
    Hand-drawn locked copper for the USB pair (through U12 into J3), the CAN
    pair and the U8 buck power stage (route_critical.py), then Freerouting
    with B.Cu weighted expensive, phase-1's finish_routes with 2-layer
    settings, and PGND stitching between the two ground pours.
    PGND is now poured on both layers (3V3 runs as 0.4 mm tracks). Placement
    in gen_board.py was reworked against the netlist and U8 gets an IPC-size
    board-local courtyard. Fab outputs regenerated.
    phase1 finish_routes.py gains FILL_AROUND/B_COST hooks (defaults keep
    phase-1 behaviour), skips rule areas, and loads the base board first so
    LoadBoard no longer resets the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
    [phase3-manager.kicad_pcb]
2026-09-27 Phase-1 100x80 (WIP): re-place output section around the 17 mm L1 land
    Placement, pours and pass-1 copper for the 100 x 80 board; routing to follow.
    Also corrects the Phase-1 F1 BOM note (direct-solder mini blade land).
    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
    [phase1-module.kicad_pcb]
2026-09-27 Phase-1 100x80 (WIP): turn U6 so gate/source/BST pins face their parts
    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
    [phase1-module.kicad_pcb]
2026-09-27 Phase-1 board: 100 x 80 mm, re-routed with the BOM's L1 and U7 lands
    Shrinks the module from 120 x 80 to 100 x 80 mm for JLCPCB's <=100 x 100
    tier. The 120 x 80 layout stays on branch phase1-120x80.
    - Re-placed from the netlist, so L1 gets the 17 mm MWSA1707S/XAL1510
    superset land and U7 the SC-70-5 land the BOM orders (the old board had
    XAL1350 and SOT-23-5 lands).
    - Output bank tightened round L1; R27 moved to the top strip.
    - R30, U4, U5 and the Kelvin pair moved as one block, same geometry.
    - Q3/Q4, J4 and the LTC7004 stack down the right edge; U6 now below the
    seam, so the AGND pocket is gone.
    - gen_board checks real courtyard polygons, not bounding boxes.
    - Routed: 0 unconnected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
    [phase1-module-bom.csv, phase1-module.kicad_pcb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]
2026-09-27 Phase-1: keep the FB sense run 5.5 mm from SW copper
    Freerouting ran VOUT_INT's FB run 0.25 mm past the SW island. fb_reroute.py
    rips it and re-routes with SW copper grown by 5.5 mm as a keep-out on every
    layer: now 52 mm, >= 5.56 mm from SW. DRC unchanged (0 errors, 11 silk
    warnings). Fab zip and CPL regenerated.
    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
    [phase1-module.kicad_pcb]
2026-09-27 Fix manager ENC1, F1 and BZ1 part numbers to fit their existing lands
    - ENC1: C2831776 was a 100 uF/50 V electrolytic, not an encoder. Now Alps
    EC11E18244A5 (C255515), the EC11E with push switch the footprint is for.
    - F1: C3207114 was a 6.35 mm cylindrical fuse clip. The land is a
    direct-solder MINI blade, so F1 is now the 2 A fuse itself, Littelfuse
    0297002.WXNV (C151091). The Phase-1 F1 note is corrected the same way.
    - BZ1: MLT-8530 is rated 2.5-4.5 V but runs from 5V0. Now YX-SMD8530P
    (C781886), rated 2-5 V, with the same vendor land and pad-1 (+) corner.
    Schematic LCSC/MPN fields and BOM CSVs regenerated with common/bom.py.
    No footprint or layout change.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
    [phase1-module-bom.csv, phase3-manager-bom.csv, phase3-manager-jlcpcb.csv, power-can.kicad_sch, ui.kicad_sch]
2026-09-27 phase2: rework LM5143 corner and port the phase-1 routing tools
    Move C28 below U3 and the compensation cluster east of the NE B.Cu
    corridor so U3's control pins escape cleanly; hand-route the right-column
    lanes and the top-row via fan-out in route_board.py. Drop the old PS_VIN
    and PH_CS_B F.Cu corridors (now routed on In2). Port fanout.py and
    finish_routes.py (adds --inner In2 routing, --only, --first, --budget),
    and the phase-1 DSN export / SES import.
    Board file is regenerated and routed in a follow-up commit.
    Claude-Session: https://claude.ai/code/session_01CT7ZUC1wFK39SLj4Qnh9qy
    [export_dsn.py, fanout.py, finish_routes.py, gen_board.py, import_ses.py, route_board.py]
2026-09-27 phase2: hand routes for U3 bottom row, U4 analog ground, output-cap vias
    Join U3 PGND pins 14/17 under the body and drop 17 into the pour; feed
    C22/C23 PS_VCC from a via between them. Escape VOUT2 (pin 5) west to In2.
    Turn C25 so COMP meets R24 directly and its AGND pad gets a pocket via.
    Gather U4/C31/C33 AGND on F.Cu to one via, link C33 5V0, and tie the
    output-cap PGND pads (C15/C47/C16) down to In1/B.Cu PGND.
    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
2026-09-27 phase2: route VOUT2 and COMP2 inside U3's pad ring, free RT1
    VOUT2 (pin 5) joins VOUT1 (pin 26) through the channel between U3's pad
    ring and exposed pad; COMP2 dives there on a 0.5 mm via. PGND pins 14/17
    link outside the pad row with G_LS_B moved west of the link. RT1 gets its
    own AGND and NTC_FET vias; C25's AGND via moves to free the RES lane.
    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
2026-09-27 phase2 finish_routes: keep routes 0.85 mm off the board edge
    The grid margin was 0.6 mm to the track centre, so a 0.3 mm power track
    landed 0.45 mm from Edge.Cuts against the 0.5 mm board-edge rule.
    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
2026-09-27 phase2: finish routing (0 unconnected, 0 DRC errors) and generate fab outputs
    Freerouting plus finish_routes closed all but EAI_INJ; CAN_TX's router
    copper fenced the MCU area, so it was stripped and re-routed after
    EAI_INJ. Silk, planes (PS-002 clear), DRC, gerbers/drill zip and the
    JLCPCB CPL are regenerated. Adds tools/README.md and strip_routes.py,
    and updates HANDOVER.
    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
    [phase2-module.kicad_pcb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]
2026-09-28 Manager J3: order the GCT USB4105-GF-A that the board is routed for
    The manager board's USB breakout is drawn to the USB4105 land, but the BOM
    listed the HRO TYPE-C-31-M-12, whose signal pads are 0.3 mm longer and
    whose shell stakes sit elsewhere. Dropping it onto the routed board gives
    38 DRC errors round J3, so the part follows the copper instead:
    USB4105-GF-A, C3020560, held in JLCPCB assembly stock (1.1k) though LCSC
    retail shows none. USB4105-GF-A-120 (C5184243, 4.7k) is the backup.
    Claude-Session: https://claude.ai/code/session_012vqeoXfZfZw2oZCwv9rjfw
    [mcu.kicad_sch, phase3-manager-bom.csv, phase3-manager-jlcpcb.csv]
2026-09-28 BOM: stocked INA228 grade and 10x10 hybrid caps for phase-2
    U5 (phase-2) and the backplane U1 move to INA228AQDGSRQ1, the automotive
    grade Phase-1 already uses: same VSSOP-10 pinout and register map, in
    stock where the AIDGSR is not. C15/16/36/37 become Panasonic EEHZA1V221P
    (D10x10.2, 20 mOhm), which fits the CP_Elec_10x10.5 land; the old D8
    pick did not, and SUNCON 35HVH220M+P is noted as the same-land fallback.
    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
    [phase1-module-bom.csv, phase2-module-bom.csv, phase2-module-jlcpcb.csv, phase3-backplane-bom.csv, phase3-backplane-jlcpcb.csv, phase3-backplane.kicad_sch, power-stage.kicad_sch, sensing.kicad_sch]
2026-09-28 Module firmware 0.2: OCP backup and OVP latch (protection rows 2 and 4)
    Row 2: lb_core_ocp_sample latches OCP_BACKUP when the INA240 current
    (ADC, every 1 ms) exceeds 110 % of i_max, or the INA228 ALERT is low,
    for more than 5 ms with the output closed. ina228.c now programs SOVL
    to the same limit (1.25 uV/LSB at ADCRANGE=1) and DIAG_ALRT to
    transparent, active-low, per-conversion compare. Host-tested.
    Row 4: PB4 reads OVP_TRIP (TLV7011 output). Its EXTI4 rising edge sets
    PS_OFF and clears OUT_REQ within microseconds; the 1 ms tick latches
    OVP_HW, and re-latches after RESET while the comparator is still high.
    Claude-Sessi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
    [board.h, drv.h, ina228.c, main.c, startup.c]
2026-09-28 Phase-1 board: route OVP_TRIP to MCU PB4 so the OVP trip can latch
    The TLV7011 output only reached Q9 (disconnect), so an overvoltage
    opened the output but left the LM5145 running and nothing latched.
    OVP_TRIP now also goes to U10 pin 41 (PB4, a spare pin), where the
    firmware 0.2 EXTI handler kills EN and latches OVP_HW.
    Schematic: surgical edits (OVP_TRIP local labels -> global, PB4
    no-connect -> OVP_TRIP label); gen_phase1.py / sheets_common.py
    mirror it (ovp_to_mcu param, EXPECTED_NETS). check_netlist and
    check_footprints pass.
    Board: 21 signal nets in the U10-U7 region ripped and re-routed with
    Freerouting 1.9 + finish_routes, fb_reroute rerun, three overlap stubs
    trimmed. DRC: 0 uncon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
    [disconnect.kicad_sch, mcu-can.kicad_sch, phase1-module.kicad_pcb]
2026-09-28 Docs: protection rows 2 and 4 as implemented in firmware 0.2
    docs/04 matrix rows 2 and 4 and a design note on where the OVP latch
    lives; docs/07 pin map (PB4) and tick order; docs/12 bench-test
    predictions for rows 2 and 4 now expect a latch; HANDOVER firmware row.
    Claude-Session: https://claude.ai/code/session_01NmR2rbcK8CFj3PgzqsaRtW
2026-09-29 Manager and backplane: add JLCPCB placement (CPL) files
    Generated with common/cpl.py from the released boards, matching the
    phase-1 and phase-2 CPL files, so all four boards ship the same order set.
    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
    [phase3-backplane-cpl.csv, phase3-manager-cpl.csv]
2026-10-05 Manager L2 and backplane C2: pick stocked parts, re-route L2 as an ECO
    Manager L2 (33u/1.2A aux-buck inductor) had a 1210 land, and no stocked
    1210 33 uH is rated above 0.5 A. It is now the 5x5 mm cjiang
    FNR5040S330MT (C167973: Isat 1.30 A min, Irms 1.20 A min, 0.244 ohm)
    on KiCad's L_Changjiang_FNR5040S land.
    Board ECO, no full re-route:
    - L2 moves to (18.8, 48.4) so its courtyard clears C54, F1 and C50/C51;
    C54/C55 turn 180 so their 5V0 pads line up with L2's 5V0 pad (one
    straight 0.8 mm run) and their PGND pads are tied and dropped to the
    plane west of C55.
    - SW_AUX and the 5V0 head are redrawn locked, matching route_critical.py;
    PRESENT1/4-7 are re-routed round the bigger part b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
    [phase3-backplane-bom.csv, phase3-backplane-jlcpcb.csv, phase3-backplane.kicad_sch, phase3-manager-bom.csv, phase3-manager-jlcpcb.csv, phase3-manager.kicad_pcb, power-can.kicad_sch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]
2026-10-06 Docs: bring README, HANDOVER, SOURCING and guides up to date
    All four boards are routed, firmware is at 0.2, and PR #16 changed the
    manager L2 and backplane C2. The status tables, build guide and sourcing
    notes still described the July state (phase-2 with 83 unrouted
    connections, manager unrouted, 120 x 80 phase-1, unpinned Q3/Q4).
    - README / HANDOVER: current board and firmware state, branch workflow,
    the five open BOM CHECK rows and the open phase-1/2 L2 question
    - build guide: 100 x 80 board, the real section 3.3 decisions
    - SOURCING / docs/09: parts picked since (USB-C, encoder, bus shunt,
    C2, L2, Q1-Q4 stand-in), retired placeholder-footprint notes
    - LAYOUT status table, small stal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
    [phase1-module-bom.csv, phase2-module-bom.csv]
2026-10-06 Phase-1/2 L2 to the 5x5 mm land; close the last BOM CHECK rows
    Phase-1 and phase-2 L2 (33u/1.2A aux-buck inductor) sat on 1210 lands,
    and no stocked 1210 33 uH is rated above 0.5 A. Both now use the
    manager's part, cjiang FNR5040S330MT (C167973, Isat 1.30 A min), on
    L_Changjiang_FNR5040S, as an ECO on each routed board:
    - phase-1: L2 at (32.6, 61.25); the SW_AUX diagonal is re-ended on the
    new pad and a 0.4 mm F.Cu 5V0 link joins L2's via to C54's.
    - phase-2: L2 at (68.4, 57.45) r270; its SW_AUX and 5V0 vias now sit in
    the pads, the two stubs that reached them are gone, and a 0.3 mm stub
    ties C55's 5V0 via to pad 2.
    - common/eco_swap_fp.py does the in-place footprint swap (nets, fields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
    [aux-rails.kicad_sch, phase1-module-bom.csv, phase1-module-jlcpcb.csv, phase1-module.kicad_pcb, phase2-module-bom.csv, phase2-module-jlcpcb.csv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]
2026-10-10 Upgraded to kicad 10.
    [aux-rails.kicad_sch, control-core.kicad_sch, disconnect.kicad_sch, hot-swap.kicad_sch, io.kicad_sch, mcu-can.kicad_sch, phase1-module.kicad_pcb, phase2-module.kicad_pcb]
